oudehm/seniorDesignPCB/light_PCB/light_PCB.kicad_pcb

## KiCad design light_PCB/light_PCB.kicad_pcb (2026-09-28)

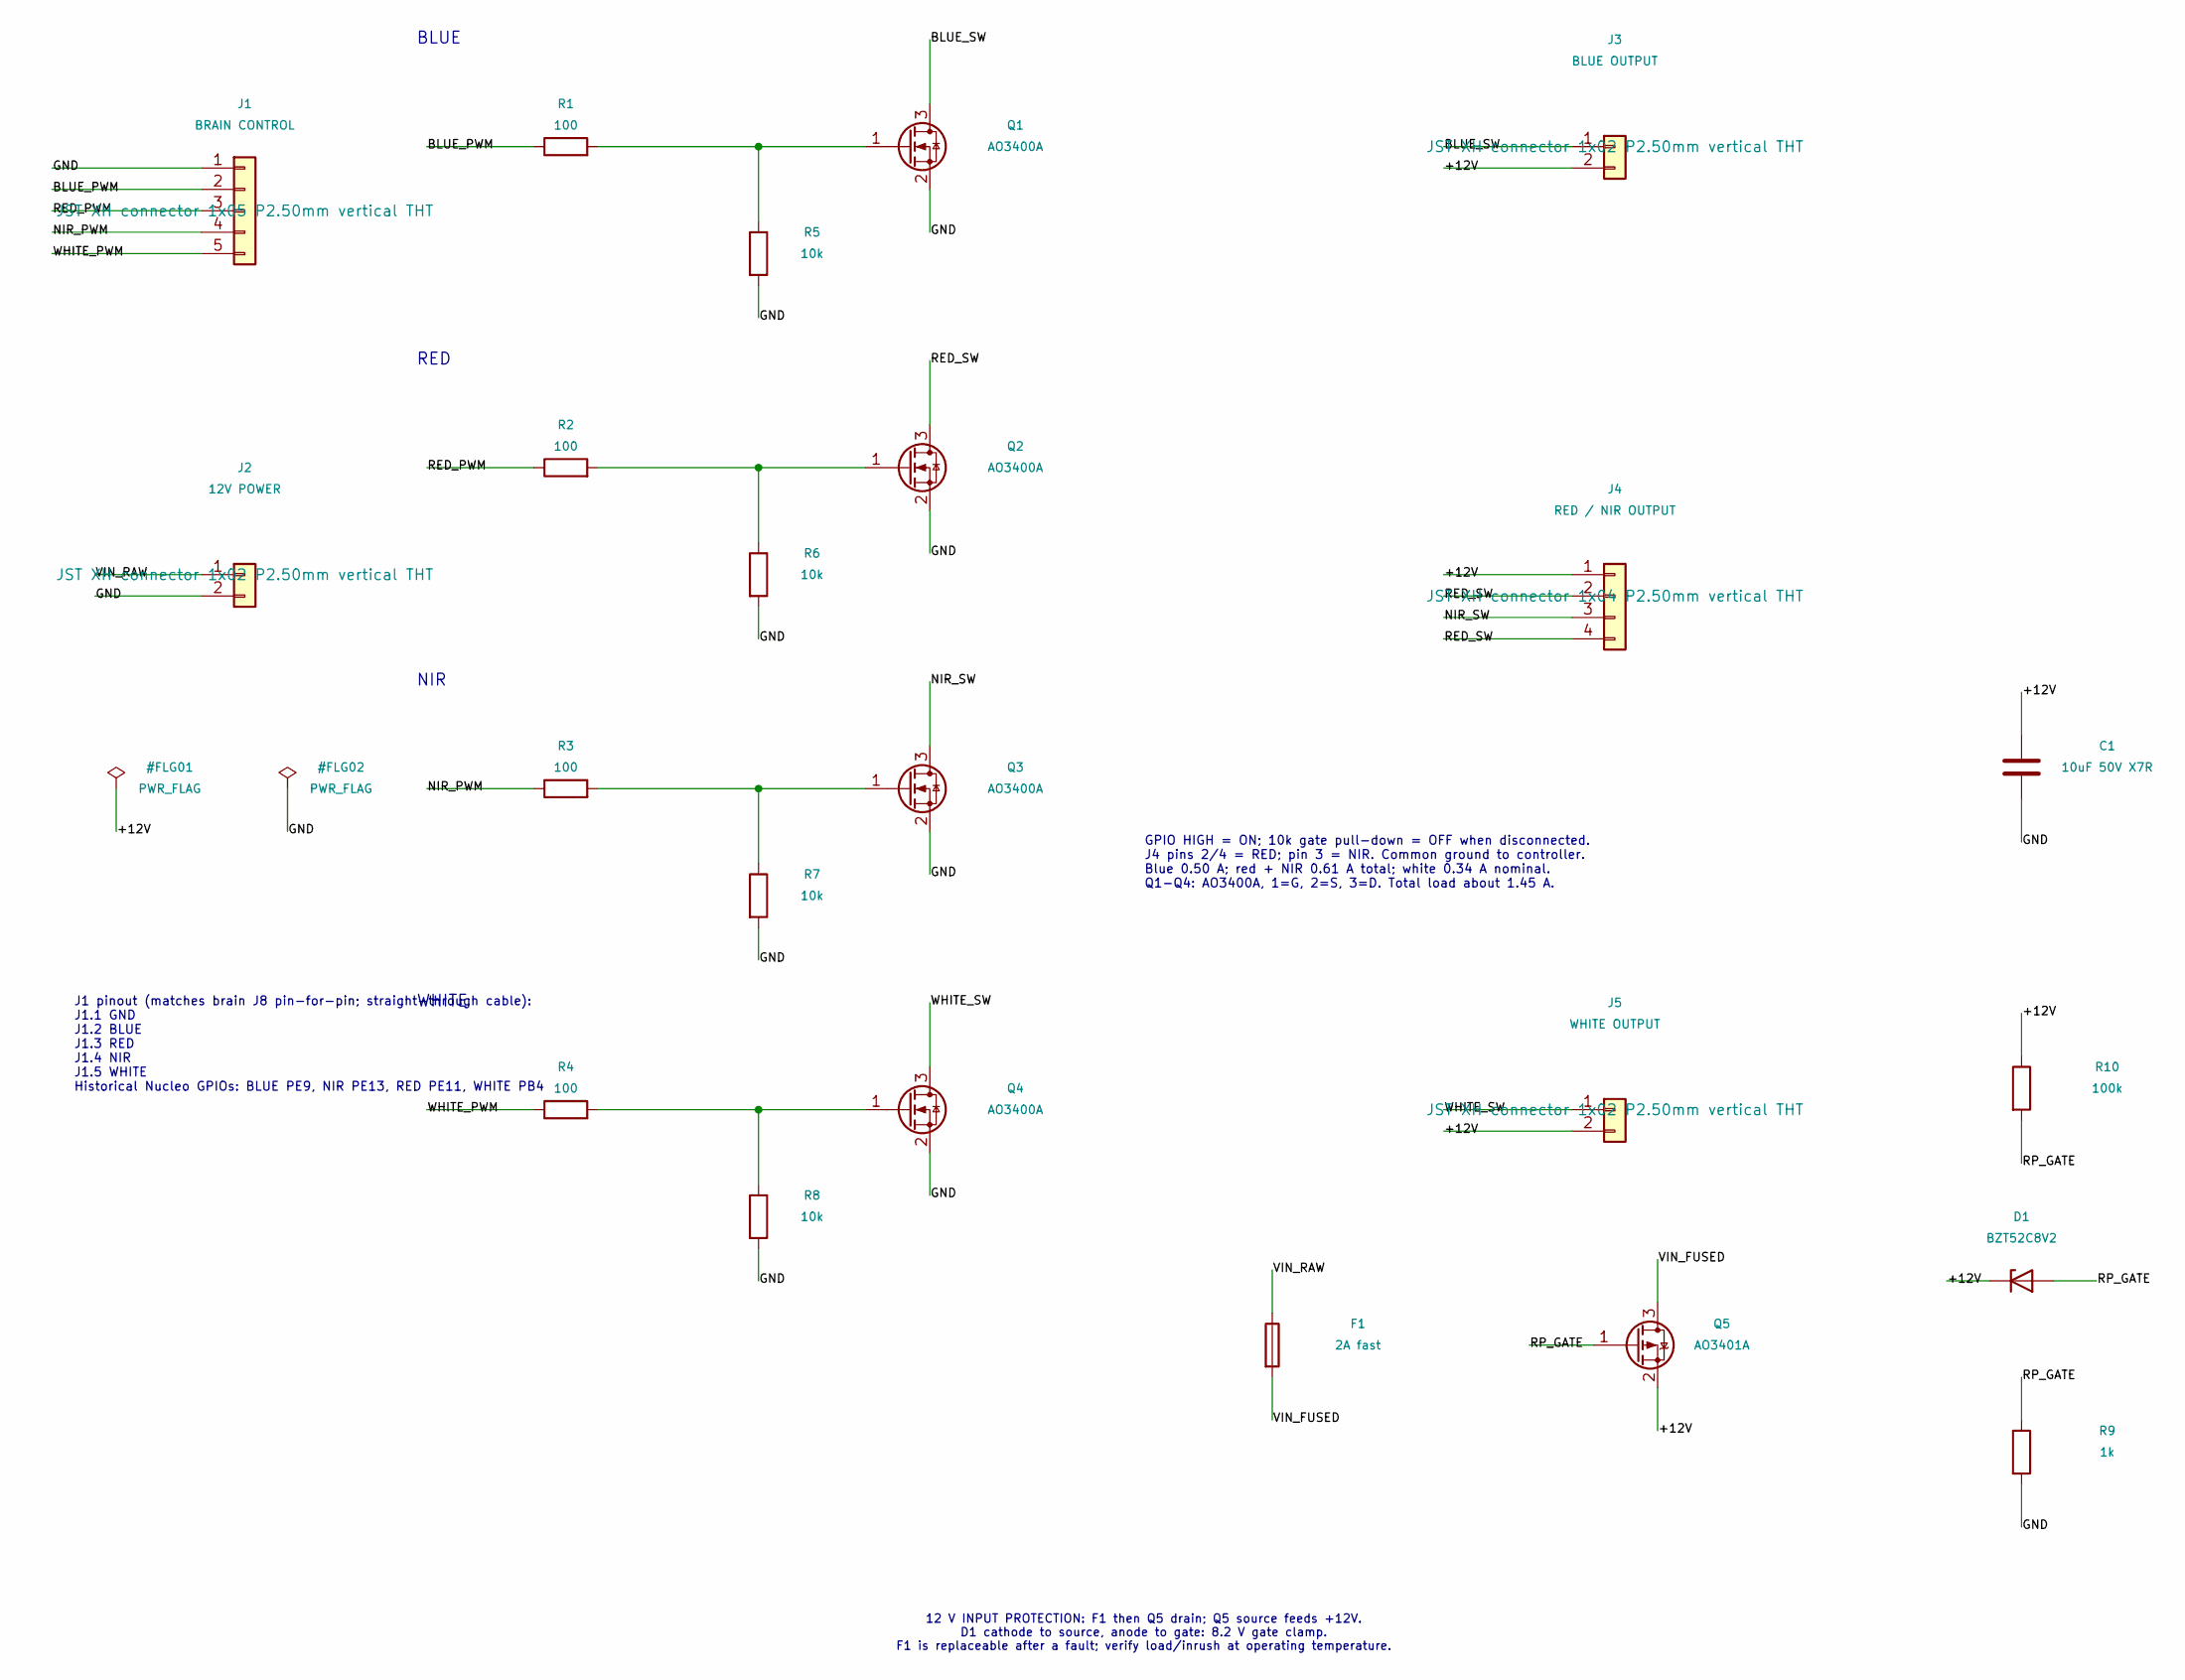
[picture p5: schematic light_PCB.kicad_sch, Hydroponic lights - protected 12 V / SMD]

Parts:
C1: 10uF 50V X7R; C_1210_3225Metric; MPN GRM32ER71H106KA12L; LCSC C77102
D1: BZT52C8V2; D_SOD-123; MPN BZT52C8V2-13-F; LCSC C3001623
F1: 2A fast; Fuse_1206_3216Metric; MPN 0466002.NRHF; LCSC C3105
J1: BRAIN CONTROL; JST_XH_B5B-XH-A_1x05_P2.50mm_Vertical; MPN B5B-XH-A(LF)(SN)
J2: 12V POWER; JST_XH_B2B-XH-A_1x02_P2.50mm_Vertical; MPN B2B-XH-A(LF)(SN)
J3: BLUE OUTPUT; JST_XH_B2B-XH-A_1x02_P2.50mm_Vertical; MPN B2B-XH-A(LF)(SN)
J4: RED / NIR OUTPUT; JST_XH_B4B-XH-A_1x04_P2.50mm_Vertical; MPN B4B-XH-A(LF)(SN)
J5: WHITE OUTPUT; JST_XH_B2B-XH-A_1x02_P2.50mm_Vertical; MPN B2B-XH-A(LF)(SN)
Q1, Q2, Q3, Q4: AO3400A; SOT-23; MPN AO3400A; LCSC C20917
Q5: AO3401A; SOT-23; MPN AO3401A; LCSC C15127
R1, R2, R3, R4: 100; R_0402_1005Metric_SilkClearance; MPN RC0402FR-07100RL; LCSC C106232
R5, R6, R7, R8: 10k; R_0402_1005Metric_SilkClearance; MPN RC0402FR-0710KL; LCSC C60490
R9: 1k; R_0603_1608Metric; MPN RC0603FR-071KL; LCSC C22548
R10: 100k; R_0603_1608Metric; MPN RC0603FR-07100KL; LCSC C14675

Connections:
/+12V: C1.1, D1.1 (K), J3.2, J4.1, J5.2, Q5.2 (S), R10.1
/BLUE_PWM: J1.2, R1.1
/BLUE_SW: J3.1, Q1.3 (D)
/GND: C1.2, J1.1, J2.2, Q1.2 (S), Q2.2 (S), Q3.2 (S), Q4.2 (S), R5.2, R6.2, R7.2, R8.2, R9.2
/NIR_PWM: J1.4, R3.1
/NIR_SW: J4.3, Q3.3 (D)
/RED_PWM: J1.3, R2.1
/RED_SW: J4.2, J4.4, Q2.3 (D)
/RP_GATE: D1.2 (A), Q5.1 (G), R9.1, R10.2
/VIN_FUSED: F1.2, Q5.3 (D)
/VIN_RAW: F1.1, J2.1
/WHITE_PWM: J1.5, R4.1
/WHITE_SW: J5.1, Q4.3 (D)
unnamed: Q1.1 (G), R1.2, R5.1
unnamed: Q2.1 (G), R2.2, R6.1
unnamed: Q3.1 (G), R3.2, R7.1
unnamed: Q4.1 (G), R4.2, R8.1

Notes on the sheet:
12 V INPUT PROTECTION: F1 then Q5 drain; Q5 source feeds +12V. D1 cathode to source, anode to gate: 8.2 V gate clamp. F1 is replaceable after a fault; verify load/inrush at operating temperature.
BLUE
WHITE
J1 pinout (matches brain J8 pin-for-pin; straight-through cable): J1.1 GND J1.2 BLUE J1.3 RED J1.4 NIR J1.5 WHITE Historical Nucleo GPIOs: BLUE PE9, NIR PE13, RED PE11, WHITE PB4
GPIO HIGH = ON; 10k gate pull-down = OFF when disconnected. J4 pins 2/4 = RED; pin 3 = NIR. Common ground to controller. Blue 0.50 A; red + NIR 0.61 A total; white 0.34 A nominal. Q1-Q4: AO3400A, 1=G, 2=S, 3=D. Total load about 1.45 A.
NIR
RED

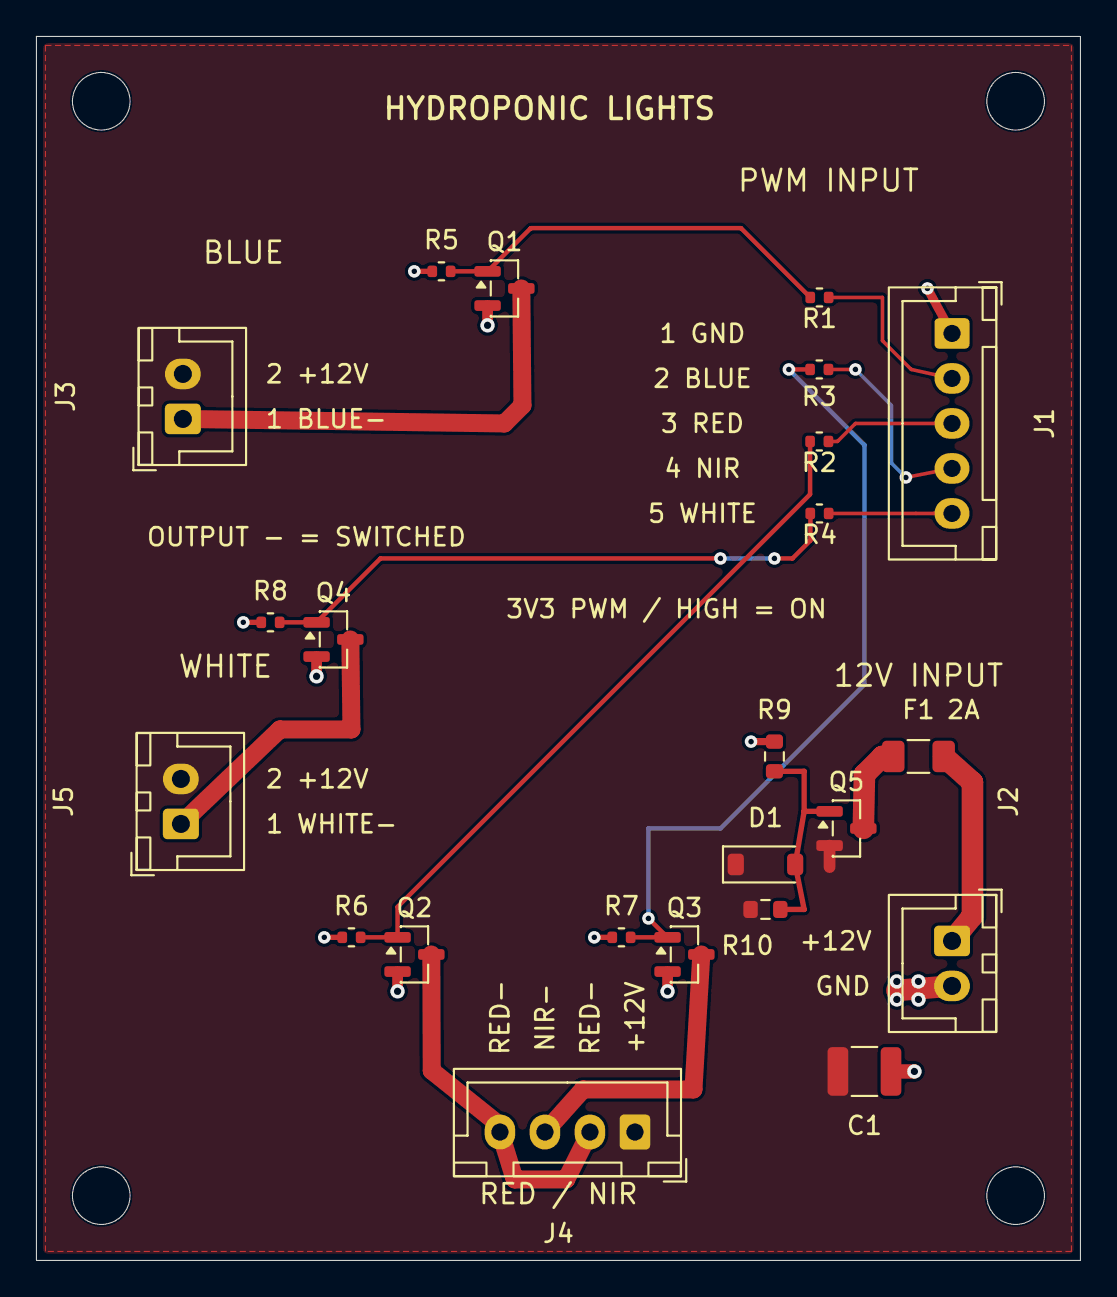
[picture p6: board light_PCB.kicad_pcb from above]

Board: 2 copper layers, 58.0 x 68.0 mm, 27 parts (0 on the bottom side), 17 nets.

Other parts of the board:
H1, H2, H3, H4: MountingHole_3.2mm_M3
