oudehm/seniorDesignPCB/brain_PCB/brain_PCB.kicad_pcb

## KiCad design brain_PCB/brain_PCB.kicad_pcb (2026-09-28)

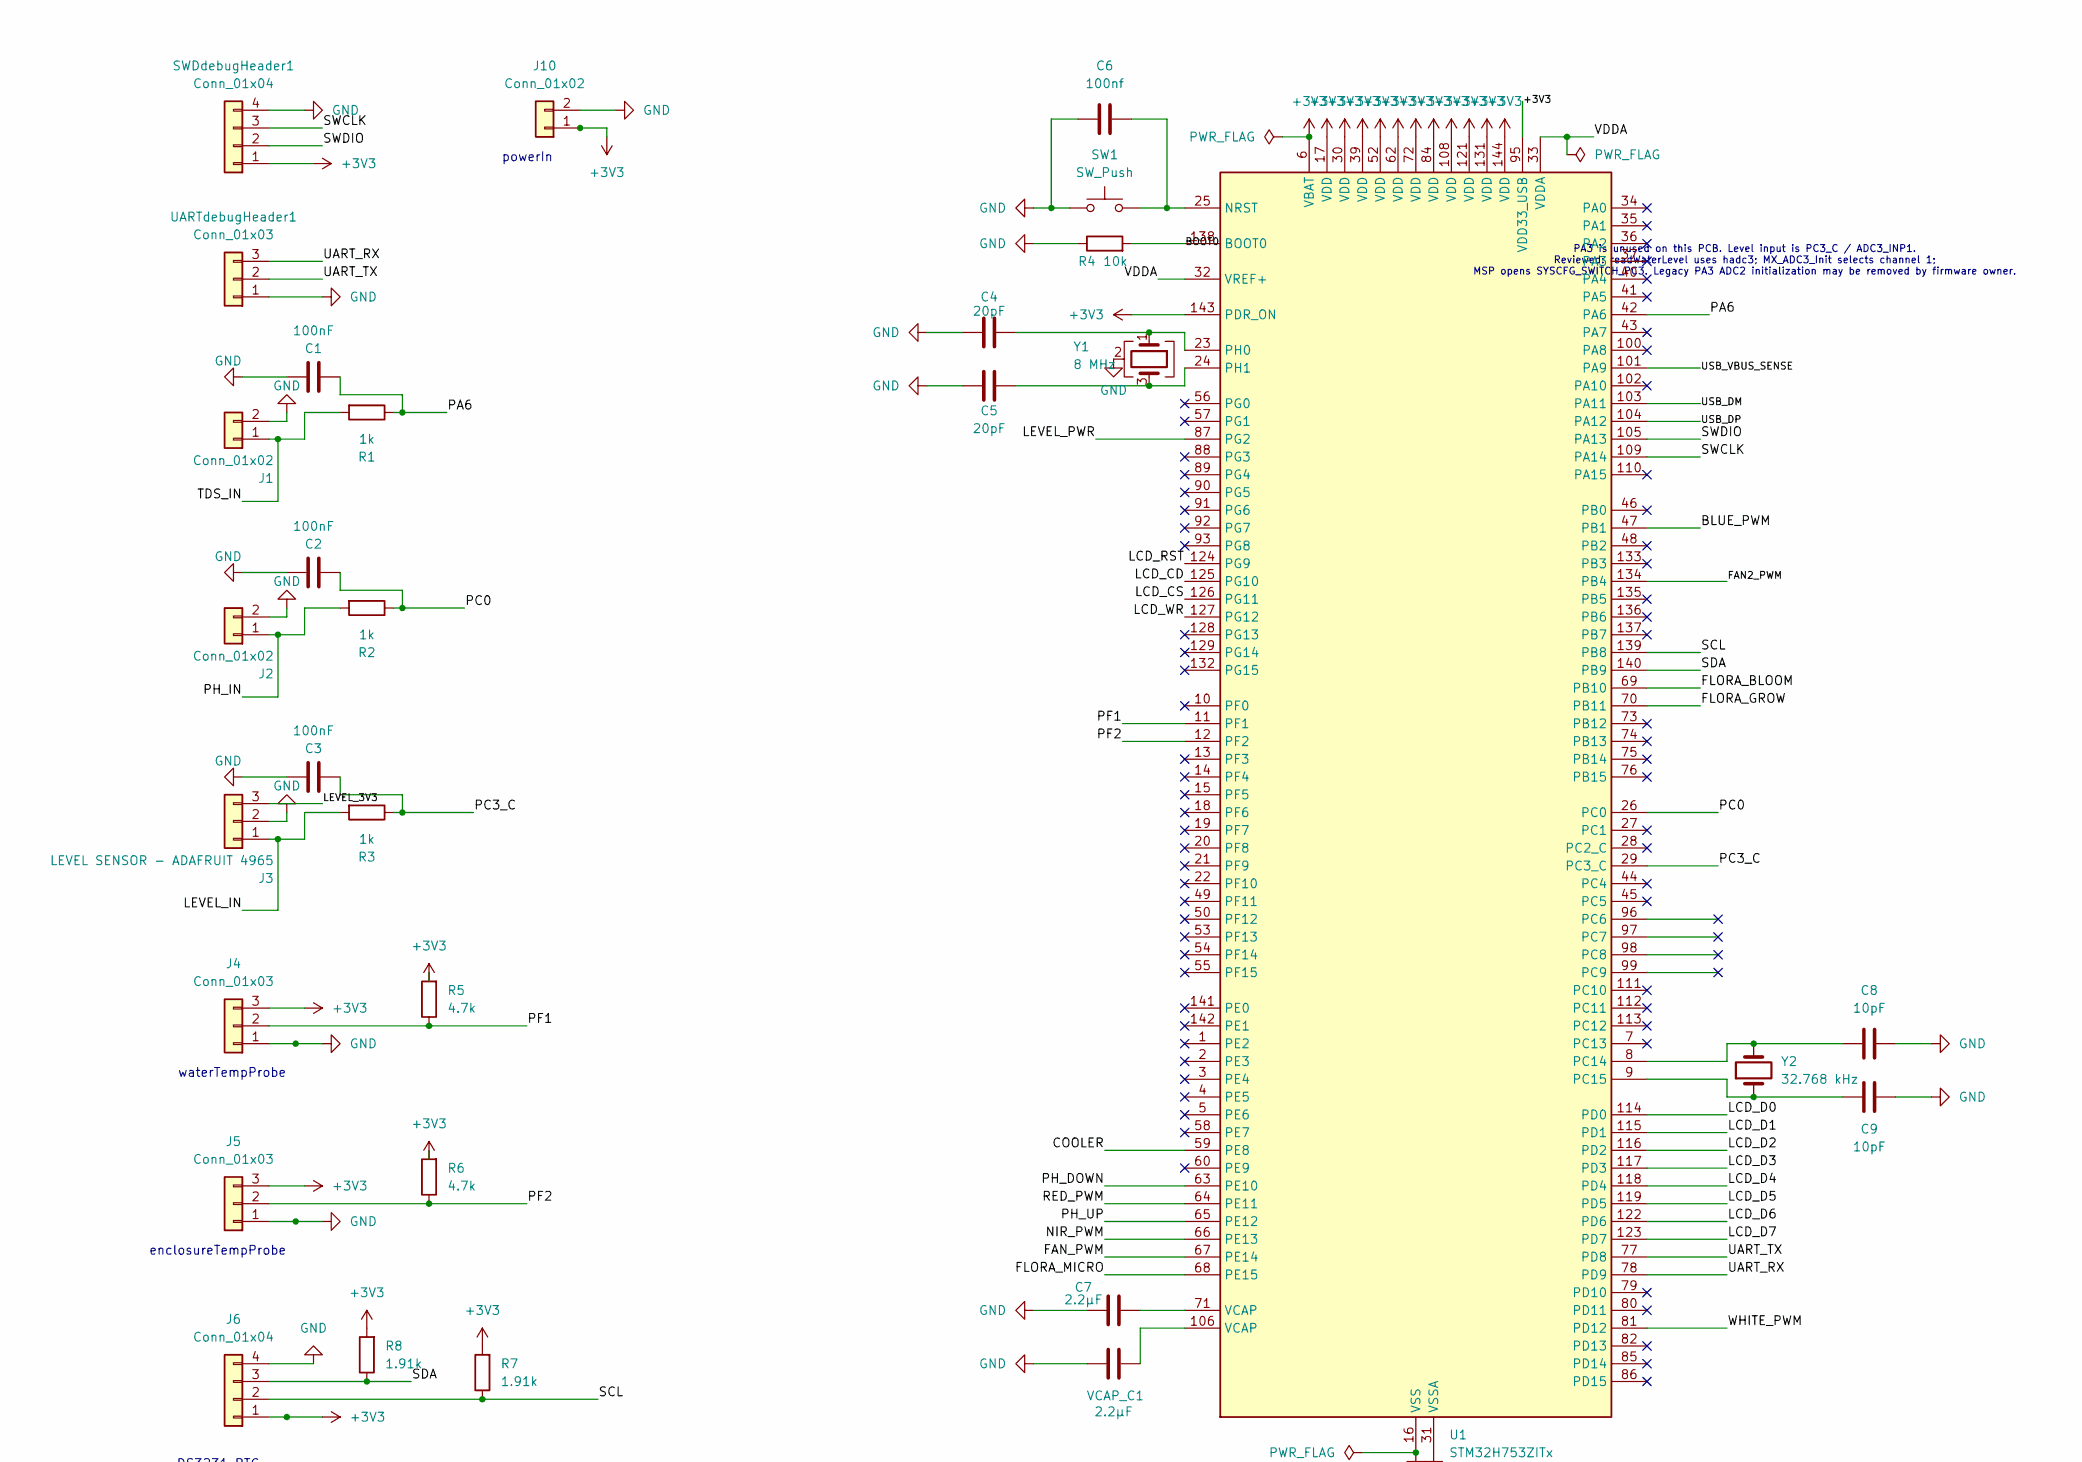
[picture p7: schematic brain_PCB.kicad_sch, part in row 1, column 1]

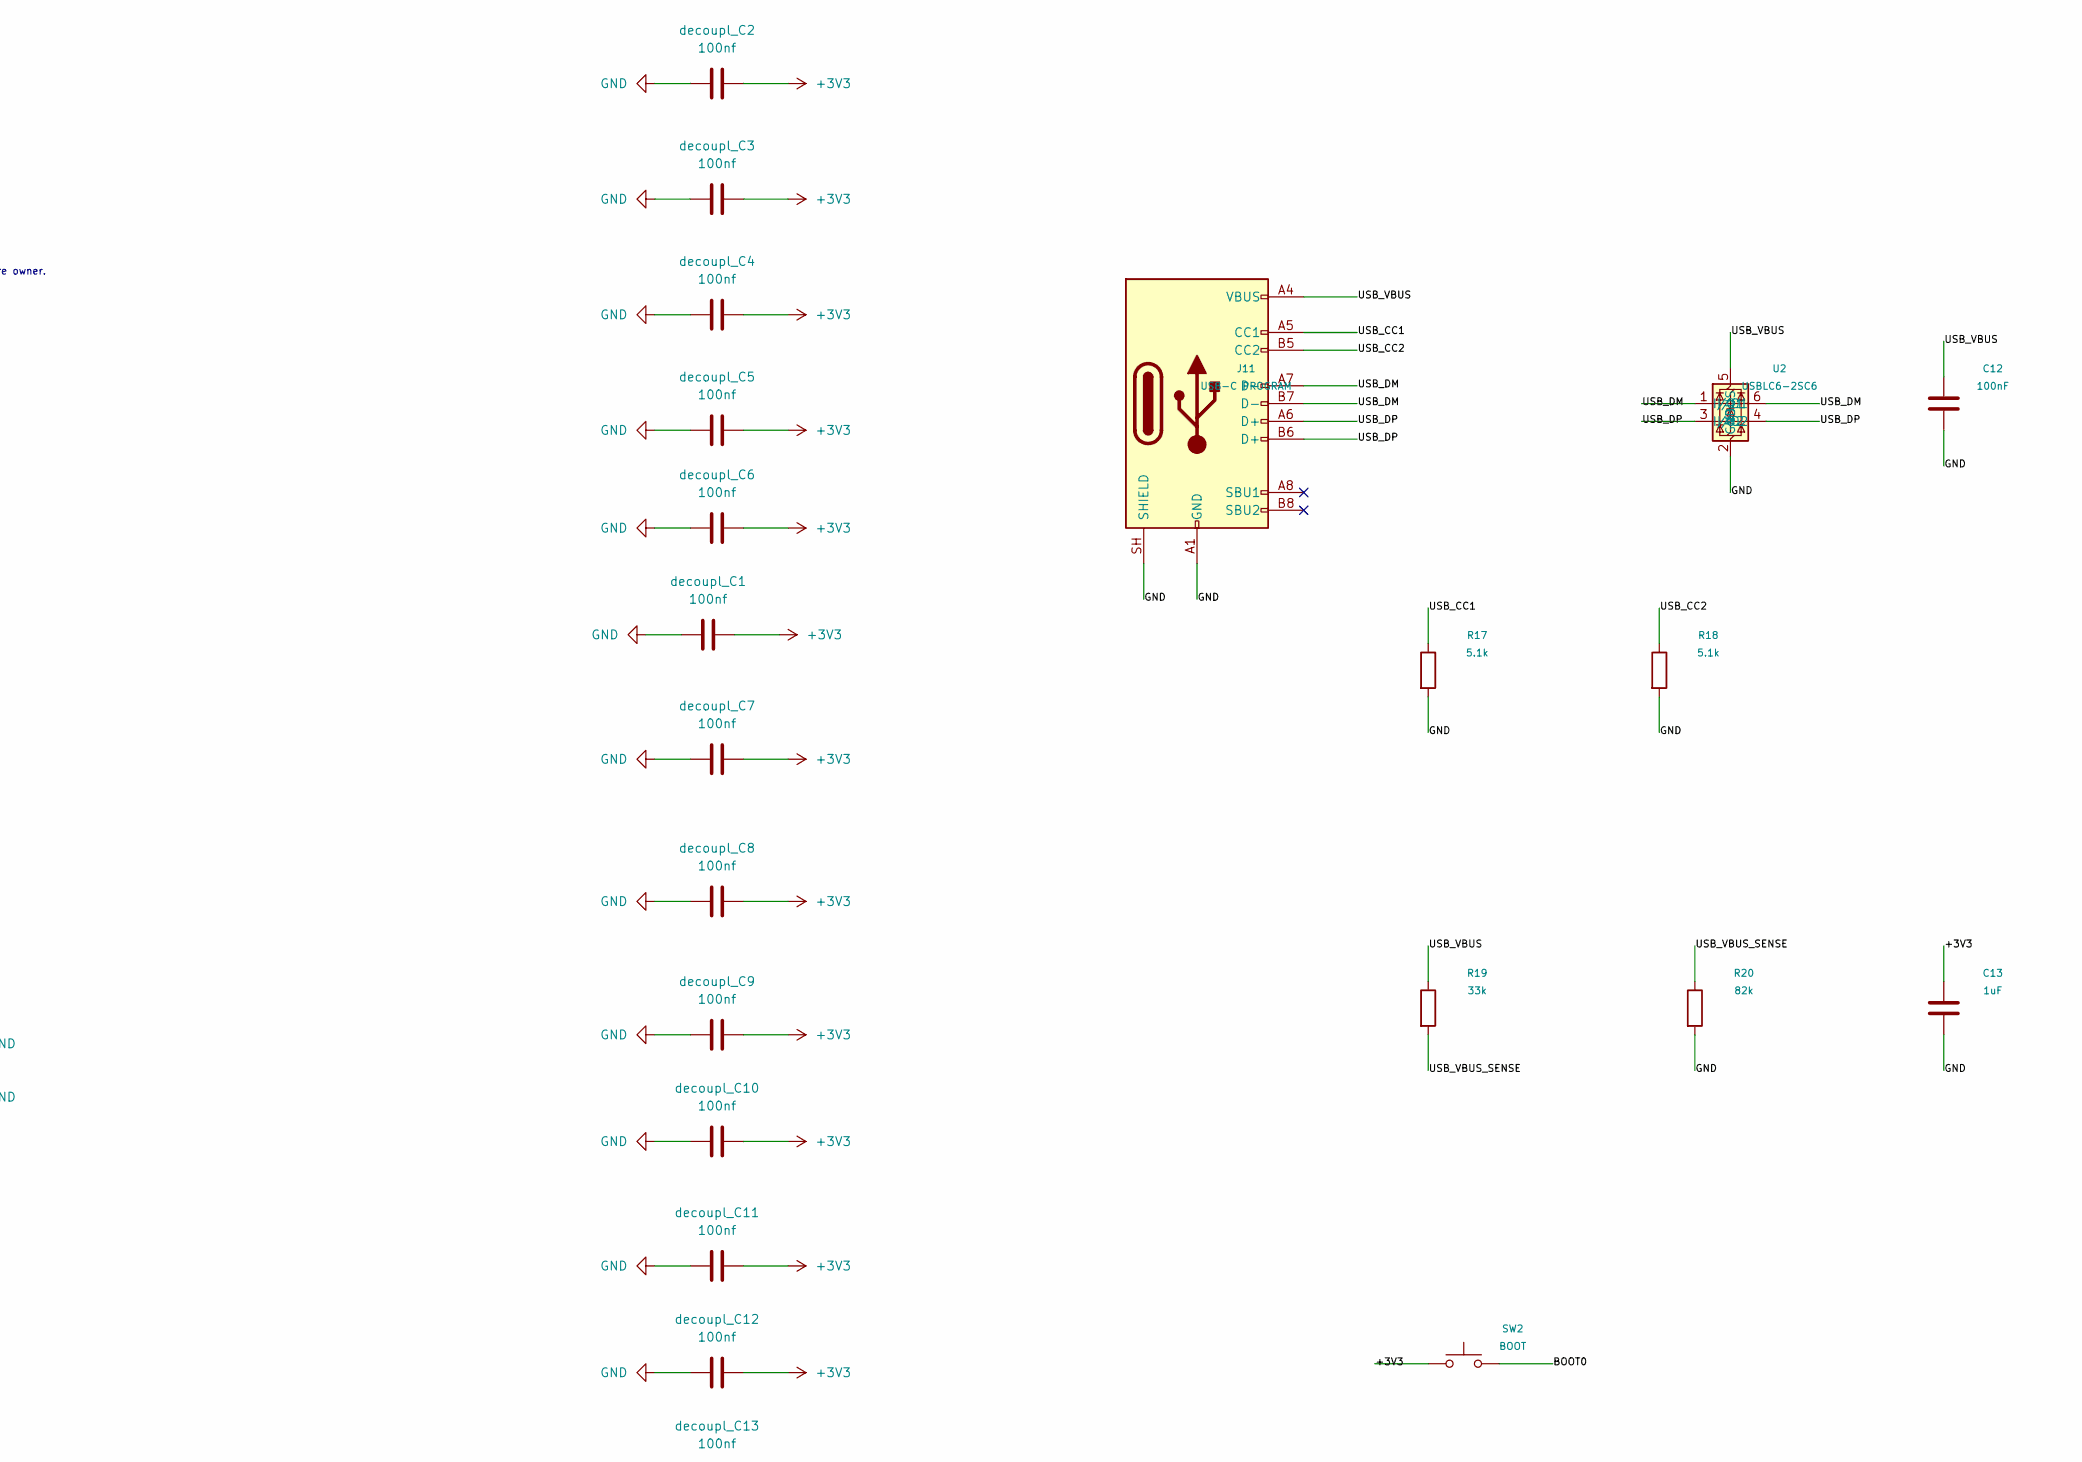
[picture p8: schematic brain_PCB.kicad_sch, part in row 1, column 2]

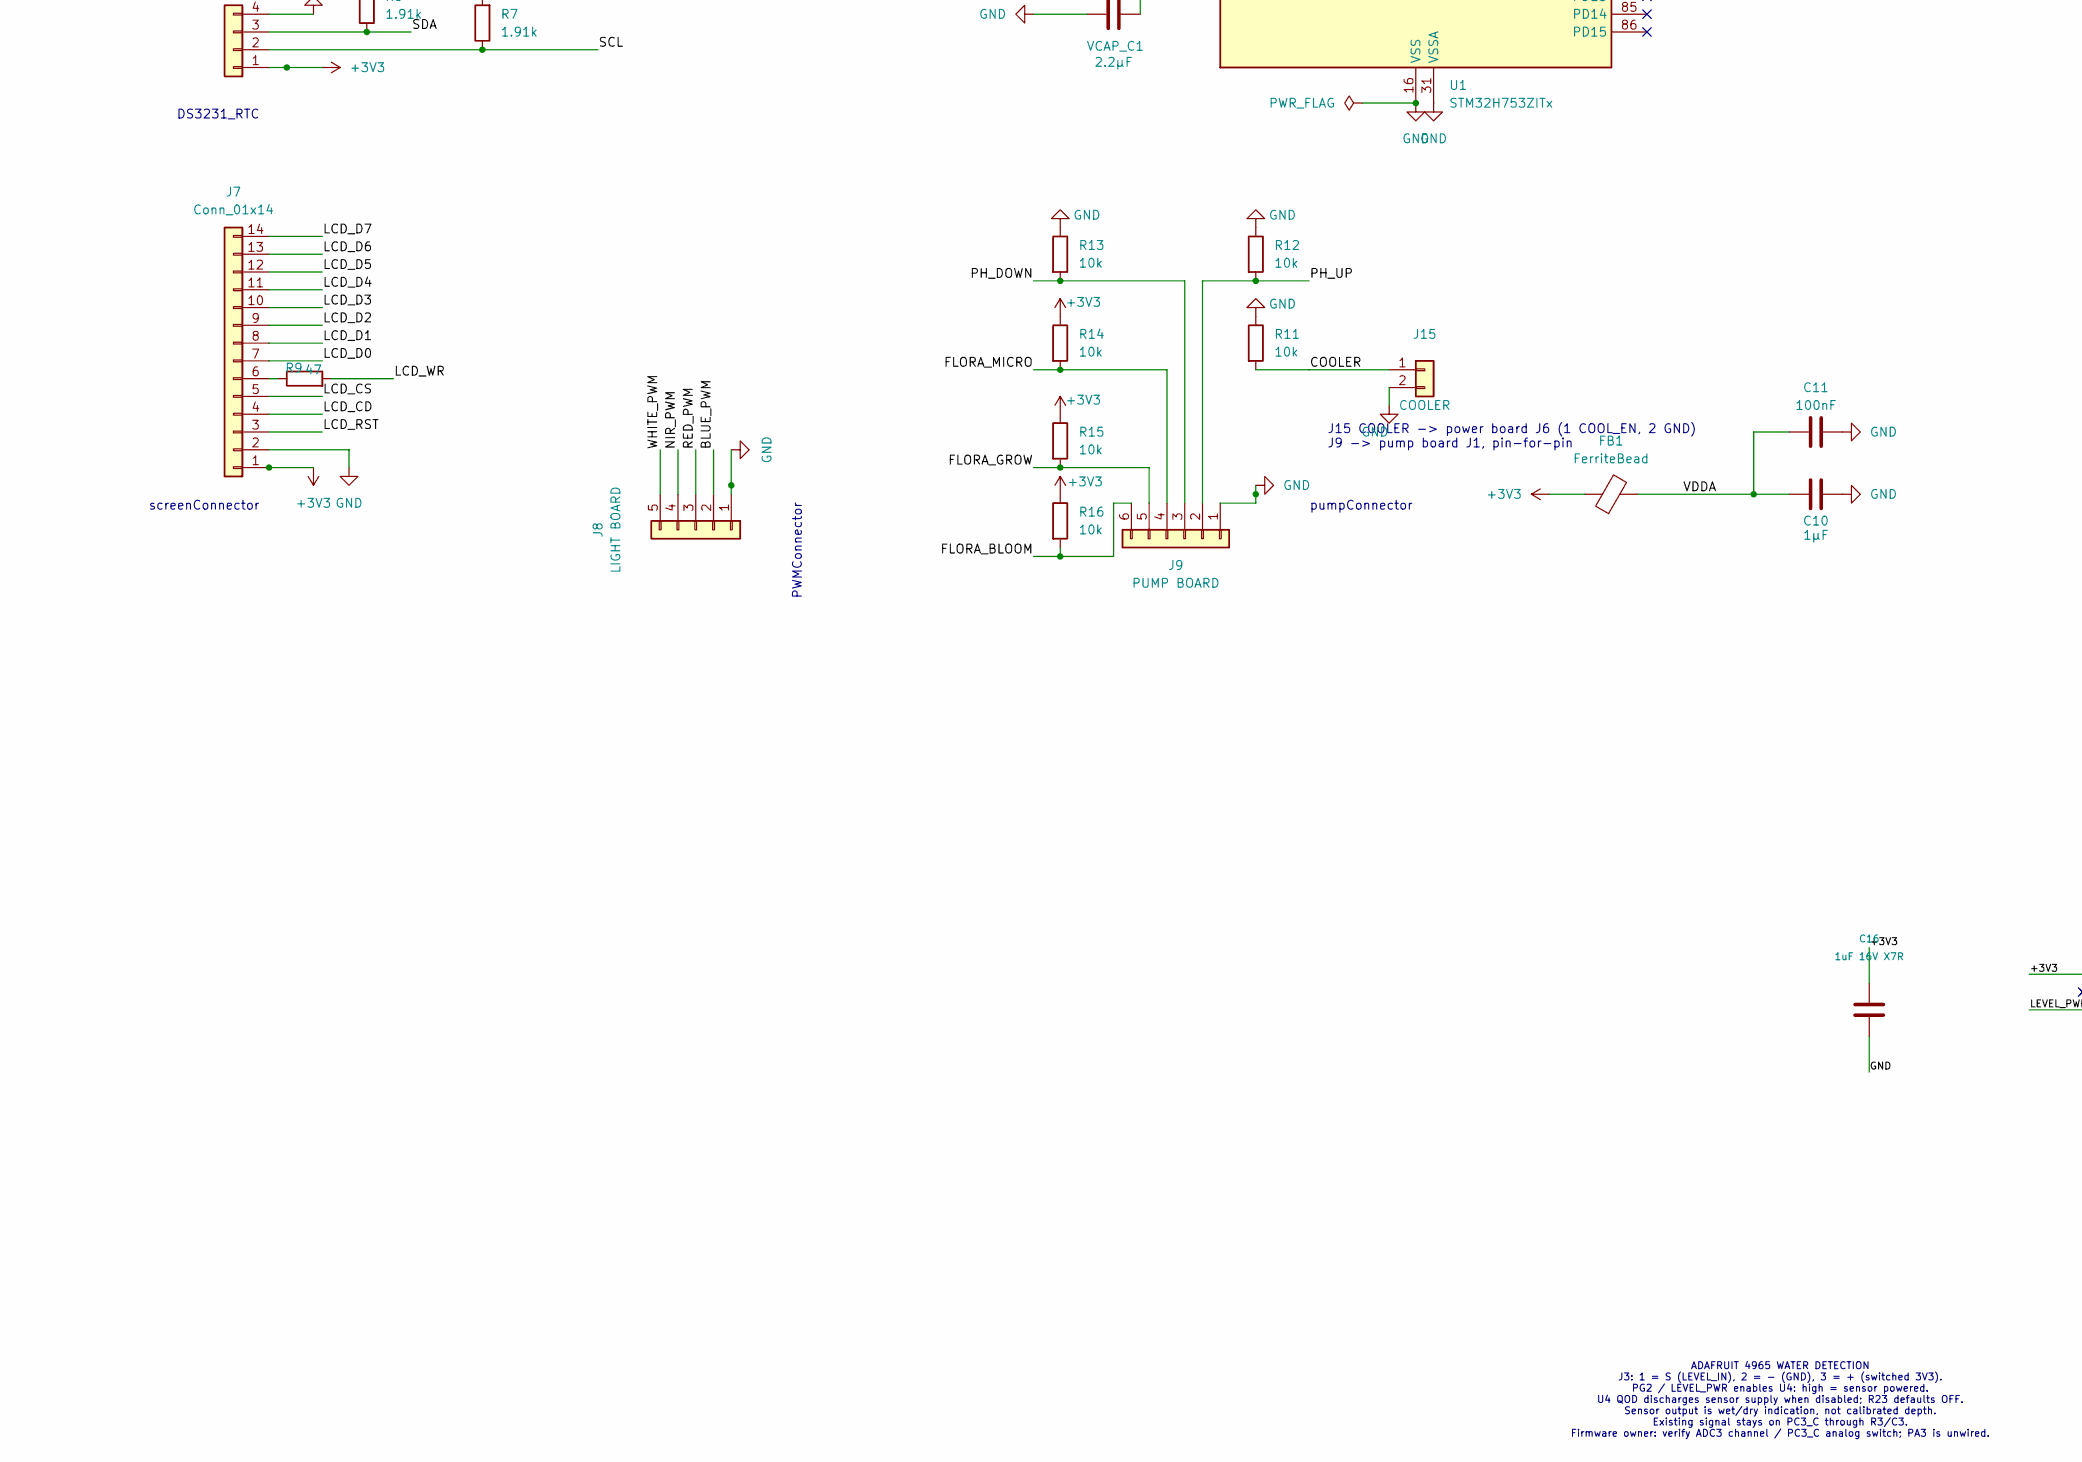
[picture p9: schematic brain_PCB.kicad_sch, part in row 2, column 1]

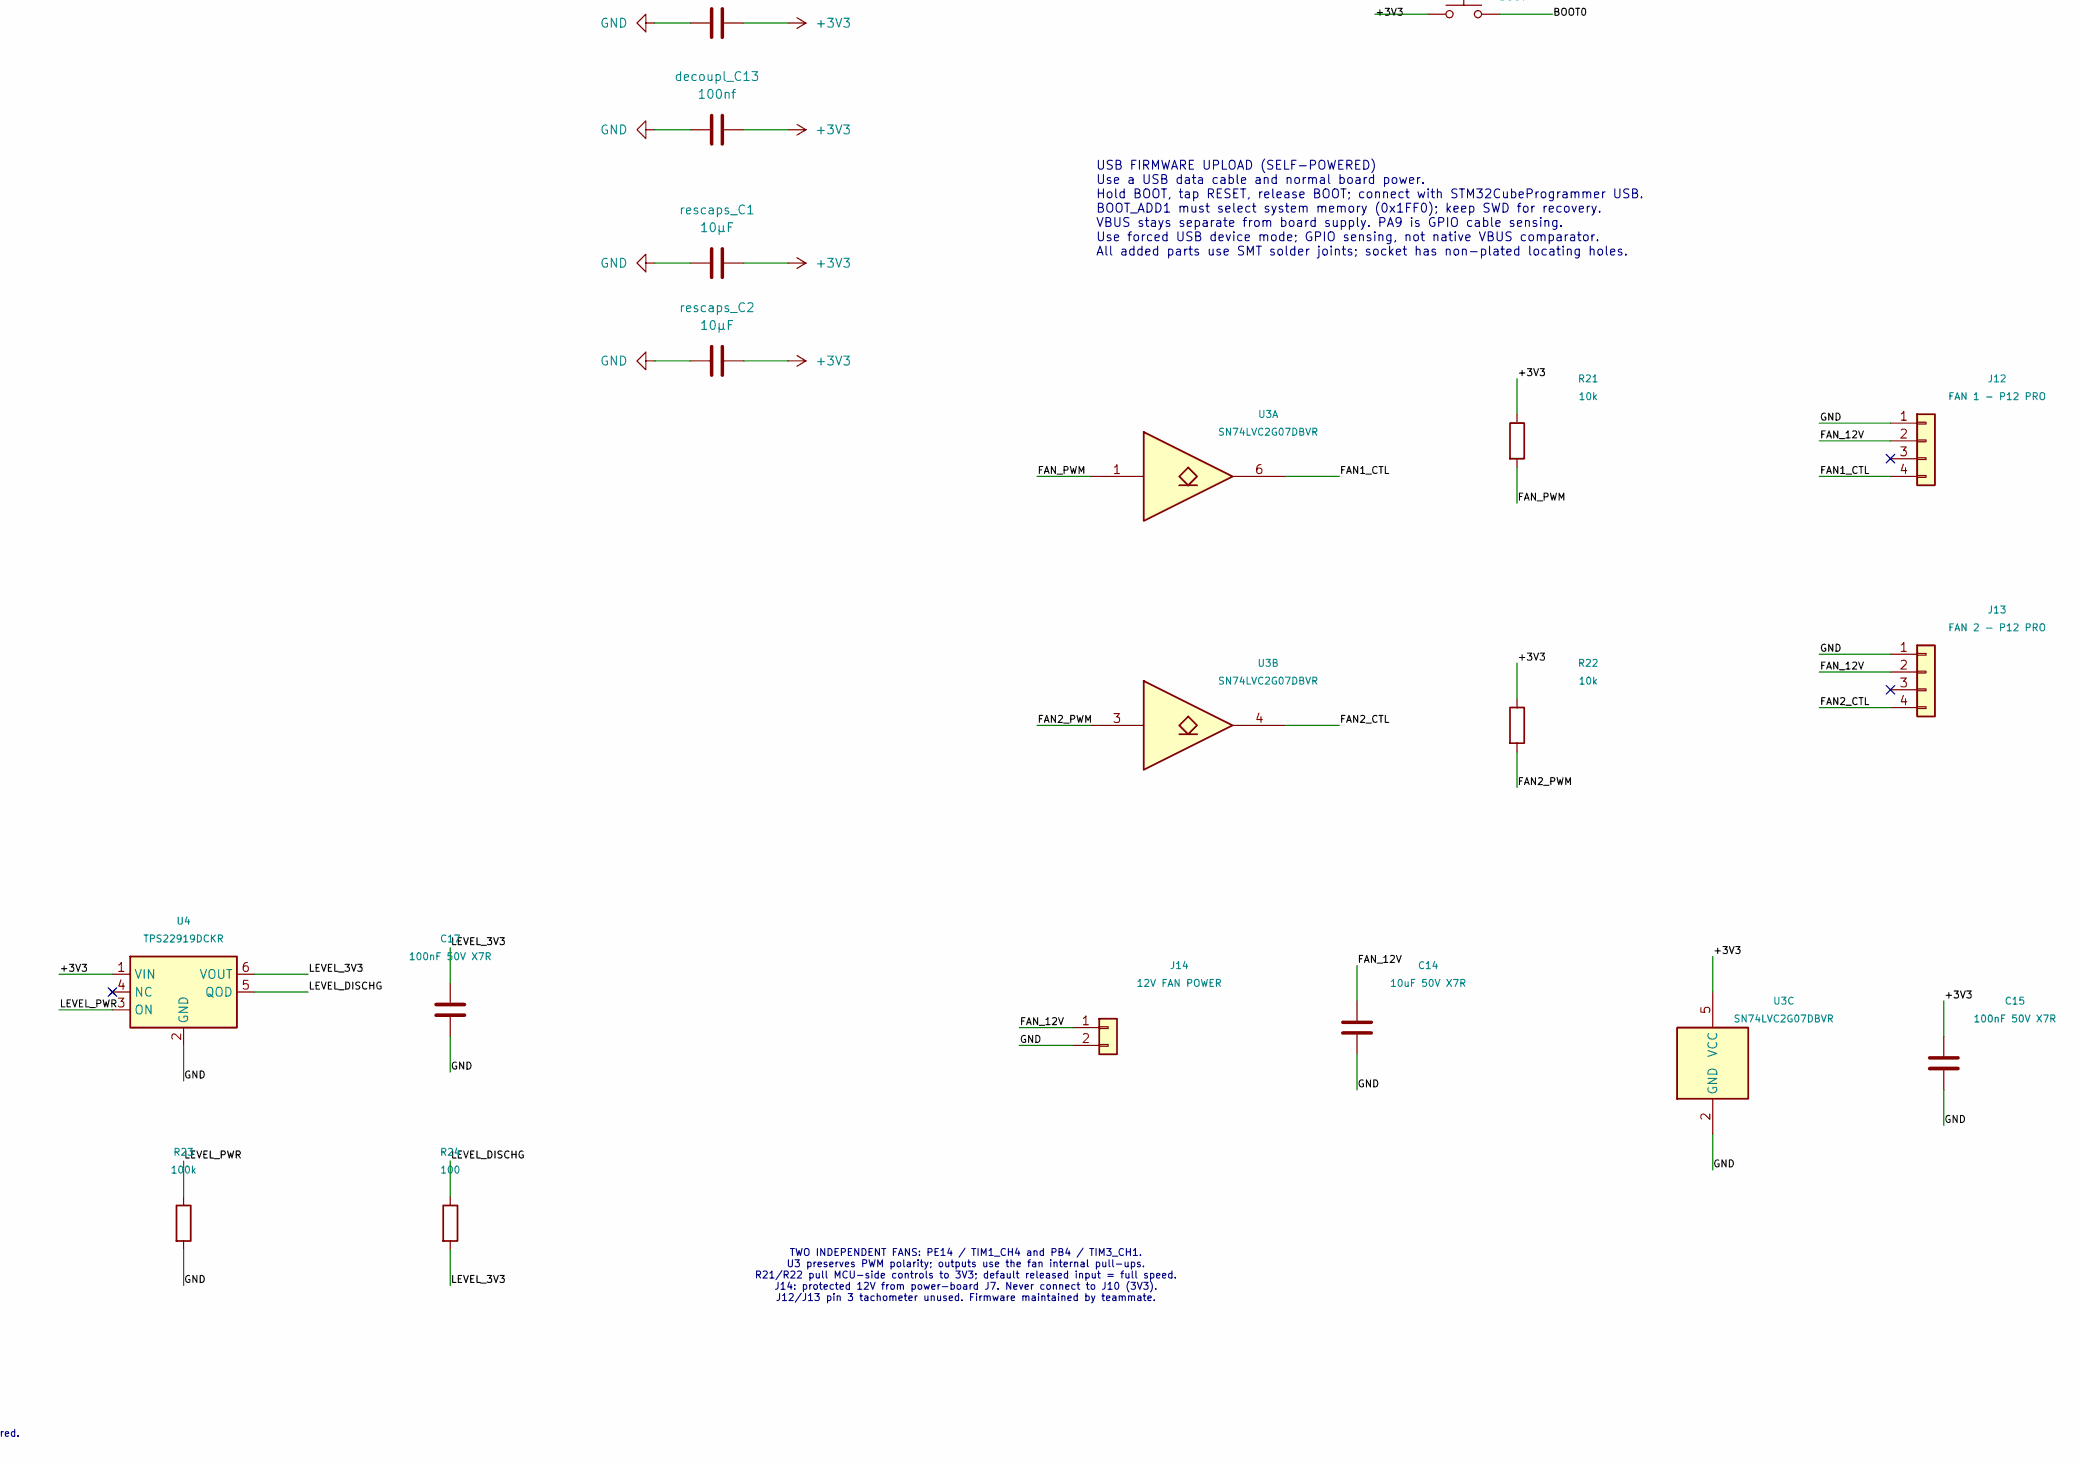
[picture p10: schematic brain_PCB.kicad_sch, part in row 2, column 2]

Parts:
C1: 100nF; C_0402_1005Metric_Reviewed_7; Rating 100nF 50V X7R; MPN GRM155R71H104KE14D; LCSC C77020
C2: 100nF; C_0402_1005Metric_Reviewed_2; Rating 100nF 50V X7R; MPN GRM155R71H104KE14D; LCSC C77020
C3: 100nF; C_0402_1005Metric_Reviewed_10; Rating 100nF 50V X7R; MPN GRM155R71H104KE14D; LCSC C77020
C4: 20pF; C_0402_1005Metric_Reviewed_8; Rating 20pF 50V C0G; MPN GRM1555C1H200JA01D; LCSC C76959
C5: 20pF; C_0402_1005Metric_Reviewed_4; Rating 20pF 50V C0G; MPN GRM1555C1H200JA01D; LCSC C76959
C6: 100nf; C_0402_1005Metric_Reviewed_9; Rating 100nF 50V X7R; MPN GRM155R71H104KE14D; LCSC C77020
C7: 2.2µF; C_0402_1005Metric_Reviewed_6; Rating 2.2uF 10V X5R; MPN GRM155R61A225KE95D; LCSC C77002
C8: 10pF; C_0402_1005Metric_Reviewed_12; Rating 10pF 50V C0G; MPN GRM1555C1H100JA01D; LCSC C76946
C9: 10pF; C_0402_1005Metric_Reviewed_4; Rating 10pF 50V C0G; MPN GRM1555C1H100JA01D; LCSC C76946
C10: 1µF; C_0402_1005Metric_Reviewed_4; Rating 1uF 10V X5R; MPN GRM155R61A105KE15D; LCSC C76999
C11: 100nF; C_0402_1005Metric_Reviewed_4; Rating 100nF 50V X7R; MPN GRM155R71H104KE14D; LCSC C77020
C12: 100nF; C_0402_1005Metric_Reviewed_3; MPN GRM155R71H104KE14D; LCSC C77020
C13: 1uF; C_0402_1005Metric_Reviewed_3; MPN GRM155R61A105KE15D; LCSC C76999
C14: 10uF 50V X7R; C_1210_3225Metric; MPN GRM32ER71H106KA12L; LCSC C77102
C15, C17: 100nF 50V X7R; C_0603_1608Metric; MPN GRM188R71H104KA93D; LCSC C77055
C16: 1uF 16V X7R; C_0603_1608Metric; Rating 1uF 25V X7R 10%, 0603; MPN GRM188R71E105KA12D; LCSC C86020
FB1: FerriteBead; L_0402_1005Metric; Rating 600 ohm at 100MHz; verify analog-rail D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; MPN BLM15AG601SN1D; LCSC C76884
J1, J2, J10: Conn_01x02; JST_XH_B2B-XH-A_1x02_P2.50mm_Vertical; MPN B2B-XH-A(LF)(SN)
J3: LEVEL SENSOR - ADAFRUIT 4965; JST_XH_B3B-XH-A_1x03_P2.50mm_Vertical; MPN B3B-XH-A(LF)(SN)
J4, J5: Conn_01x03; JST_XH_B3B-XH-A_1x03_P2.50mm_Vertical; MPN B3B-XH-A(LF)(SN)
J6: Conn_01x04; JST_XH_B4B-XH-A_1x04_P2.50mm_Vertical; MPN B4B-XH-A(LF)(SN)
J7: Conn_01x14; PinHeader_1x14_P2.54mm_Vertical; MPN 61301411121; LCSC C5907899
J8: LIGHT BOARD; JST_XH_B5B-XH-A_1x05_P2.50mm_Vertical; MPN B5B-XH-A(LF)(SN)
J9: PUMP BOARD; JST_XH_B6B-XH-A_1x06_P2.50mm_Vertical; MPN B6B-XH-A(LF)(SN)
J11: USB-C PROGRAM; USB_C_Receptacle_GCT_USB4110; MPN USB4110-GF-A; LCSC C5143397
J12: FAN 1 - P12 PRO; FanPinHeader_1x04_P2.54mm_Vertical; MPN 470531000; LCSC C240840
J13: FAN 2 - P12 PRO; FanPinHeader_1x04_P2.54mm_Vertical; MPN 470531000; LCSC C240840
J14: 12V FAN POWER; JST_XH_B2B-XH-A_1x02_P2.50mm_Vertical; MPN B2B-XH-A(LF)(SN)
J15: COOLER; JST_XH_B2B-XH-A_1x02_P2.50mm_Vertical; MPN B2B-XH-A(LF)(SN)
R1, R2, R3: 1k; R_0402_1005Metric_Reviewed_2; Rating 1%, 0402, 1/16W; MPN RC0402FR-071KL; LCSC C106235
R4, R11, R12, R13, R14, R15, R16: 10k; R_0402_1005Metric_Reviewed_1; Rating 1%, 0402, 1/16W; MPN RC0402FR-0710KL; LCSC C60490
R5: 4.7k; R_0402_1005Metric_Reviewed_1; Rating 1%, 0402, 1/16W; MPN RC0402FR-074K7L; LCSC C105871
R6: 4.7k; R_0402_1005Metric_Reviewed_6; Rating 1%, 0402, 1/16W; MPN RC0402FR-074K7L; LCSC C105871
R7, R8: 1.91k; R_0402_1005Metric_Reviewed_2; Rating 1.91kohm, 1%, 0402, 62.5mW; MPN RC0402FR-071K91L; LCSC C477598
R9: 47; R_0402_1005Metric_Reviewed_3; Rating 1%, 0402, 1/16W; MPN RC0402FR-0747RL; LCSC C137973
R17, R18: 5.1k; R_0402_1005Metric_Reviewed_5; MPN RC0402FR-075K1L; LCSC C105872
R19: 33k; R_0402_1005Metric_Reviewed_6; MPN RC0402FR-0733KL; LCSC C138003
R20: 82k; R_0402_1005Metric_Reviewed_4; MPN RC0402FR-0782KL; LCSC C137932
R21, R22: 10k; R_0603_1608Metric; MPN RC0603FR-0710KL; LCSC C98220
R23: 100k; R_0603_1608Metric; MPN RC0603FR-07100KL; LCSC C14675
R24: 100; R_0603_1608Metric; MPN RC0603FR-07100RL; LCSC C105588
SW1: SW_Push; SW_SPST_PTS645Sx43SMTR92; Rating SMT push switch; MPN PTS645SM43SMTR92 LFS; LCSC C221880
SW2: BOOT; SW_SPST_PTS645Sx43SMTR92; MPN PTS645SM43SMTR92 LFS; LCSC C221880
SWDdebugHeader1: Conn_01x04; PinHeader_1x04_P2.54mm_Vertical; MPN 61300411121; LCSC C5184785
U1: STM32H753ZITx; LQFP-144_20x20mm_P0.5mm; Rating LQFP144, -40 to 85C; MPN STM32H753ZIT6; LCSC C730207
U2: USBLC6-2SC6; SOT-23-6; MPN USBLC6-2SC6; LCSC C7519
U3: SN74LVC2G07DBVR; SOT-23-6; MPN SN74LVC2G07DBVR; LCSC C37708
U4: TPS22919DCKR; SOT-363_SC-70-6; MPN TPS22919DCKR; LCSC C2149796
UARTdebugHeader1: Conn_01x03; PinHeader_1x03_P2.54mm_Vertical; MPN 61300311121; LCSC C2915006
VCAP_C1: 2.2µF; C_0402_1005Metric_Reviewed_1; Rating 2.2uF 10V X5R; MPN GRM155R61A225KE95D; LCSC C77002
Y1: 8 MHz; Crystal_SMD_3225-4Pin_3.2x2.5mm_Reviewed_1; Rating 8MHz, CL=12pF, ESR max 400 ohm; MPN ECS-80-12-33-JGN-TR; LCSC C2442665
Y2: 32.768 kHz; Crystal_SMD_3215-2Pin_3.2x1.5mm_Reviewed_1; Rating 32.768kHz, CL=7pF; MPN ABS07-32.768KHZ-7-T; LCSC C276424
decoupl_C1, decoupl_C2, decoupl_C3: 100nf; C_0402_1005Metric_Reviewed_7; Rating 100nF 50V X7R; MPN GRM155R71H104KE14D; LCSC C77020
decoupl_C4, decoupl_C5, decoupl_C7: 100nf; C_0402_1005Metric_Reviewed_6; Rating 100nF 50V X7R; MPN GRM155R71H104KE14D; LCSC C77020
decoupl_C6: 100nf; C_0402_1005Metric_Reviewed_11; Rating 100nF 50V X7R; MPN GRM155R71H104KE14D; LCSC C77020
decoupl_C8, decoupl_C9, decoupl_C10: 100nf; C_0402_1005Metric_Reviewed_1; Rating 100nF 50V X7R; MPN GRM155R71H104KE14D; LCSC C77020
decoupl_C11, decoupl_C12: 100nf; C_0402_1005Metric_Reviewed_13; Rating 100nF 50V X7R; MPN GRM155R71H104KE14D; LCSC C77020
decoupl_C13: 100nf; C_0402_1005Metric_Reviewed_5; Rating 100nF 50V X7R; MPN GRM155R71H104KE14D; LCSC C77020
rescaps_C1, rescaps_C2: 10µF; C_0402_1005Metric_Reviewed_7; Rating 10uF 6.3V X5R; MPN GRM155R60J106ME15D; LCSC C412251

Connections:
+3V3: C13.1, C15.1, C16.1, FB1.1, J4.3, J5.3, J6.1, J7.1, J10.1, R5.2, R6.2, R7.2, R8.2, R14.1, R15.1, R16.1, R21.1, R22.1, SW2.1, SWDdebugHeader1.1, U1.6 (VBAT), U1.17 (VDD), U1.30 (VDD), U1.39 (VDD), U1.52 (VDD), U1.62 (VDD), U1.72 (VDD), U1.84 (VDD), U1.95 (VDD33_USB), U1.108 (VDD), U1.121 (VDD), U1.131 (VDD), U1.143 (PDR_ON), U1.144 (VDD), U3.5 (VCC), U4.1 (VIN), decoupl_C1.2, decoupl_C2.2, decoupl_C3.2, decoupl_C4.2, decoupl_C5.2, decoupl_C6.2, decoupl_C7.2, decoupl_C8.2, decoupl_C9.2, decoupl_C10.2, decoupl_C11.2, decoupl_C12.2, decoupl_C13.2, rescaps_C1.2, rescaps_C2.2
/BLUE_PWM: J8.2, U1.47 (PB1)
/BOOT0: R4.2, SW2.2, U1.138 (BOOT0)
/COOLER: J15.1, R11.2, U1.59 (PE8)
/FAN1_CTL: J12.4, U3.6
/FAN2_CTL: J13.4, U3.4
/FAN2_PWM: R22.2, U1.134 (PB4), U3.3
/FAN_12V: C14.1, J12.2, J13.2, J14.1
/FAN_PWM: R21.2, U1.67 (PE14), U3.1
/FLORA_BLOOM: J9.6, R16.2, U1.69 (PB10)
/FLORA_GROW: J9.5, R15.2, U1.70 (PB11)
/FLORA_MICRO: J9.4, R14.2, U1.68 (PE15)
/LCD_CD: J7.4, U1.125 (PG10)
/LCD_CS: J7.5, U1.126 (PG11)
/LCD_D0: J7.7, U1.114 (PD0)
/LCD_D1: J7.8, U1.115 (PD1)
/LCD_D2: J7.9, U1.116 (PD2)
/LCD_D3: J7.10, U1.117 (PD3)
/LCD_D4: J7.11, U1.118 (PD4)
/LCD_D5: J7.12, U1.119 (PD5)
/LCD_D6: J7.13, U1.122 (PD6)
/LCD_D7: J7.14, U1.123 (PD7)
/LCD_RST: J7.3, U1.124 (PG9)
/LCD_WR: R9.2, U1.127 (PG12)
/LEVEL_3V3: C17.1, J3.3, R24.2, U4.6 (VOUT)
/LEVEL_DISCHG: R24.1, U4.5 (QOD)
/LEVEL_IN: J3.1, R3.2
/LEVEL_PWR: R23.1, U1.87 (PG2), U4.3 (ON)
/NIR_PWM: J8.4, U1.66 (PE13)
/PA6: C1.1, R1.1, U1.42 (PA6)
/PC0: C2.1, R2.1, U1.26 (PC0)
/PC3_C: C3.1, R3.1, U1.29 (PC3_C)
/PF1: J4.2, R5.1, U1.11 (PF1)
/PF2: J5.2, R6.1, U1.12 (PF2)
/PH_DOWN: J9.3, R13.2, U1.63 (PE10)
/PH_IN: J2.1, R2.2
/PH_UP: J9.2, R12.2, U1.65 (PE12)
/RED_PWM: J8.3, U1.64 (PE11)
/SCL: J6.2, R7.1, U1.139 (PB8)
/SDA: J6.3, R8.1, U1.140 (PB9)
/SWCLK: SWDdebugHeader1.3, U1.109 (PA14)
/SWDIO: SWDdebugHeader1.2, U1.105 (PA13)
/TDS_IN: J1.1, R1.2
/UART_RX: U1.78 (PD9), UARTdebugHeader1.3
/UART_TX: U1.77 (PD8), UARTdebugHeader1.2
/USB_CC1: J11.A5 (CC1), R17.1
/USB_CC2: J11.B5 (CC2), R18.1
/USB_DM: J11.A7 (D-), J11.B7 (D-), U1.103 (PA11), U2.1 (I/O1), U2.6 (I/O1)
/USB_DP: J11.A6 (D+), J11.B6 (D+), U1.104 (PA12), U2.3 (I/O2), U2.4 (I/O2)
/USB_VBUS: C12.1, J11.A4 (VBUS), J11.A9 (VBUS), J11.B4 (VBUS), J11.B9 (VBUS), R19.1, U2.5 (VBUS)
/USB_VBUS_SENSE: R19.2, R20.1, U1.101 (PA9)
/VDDA: C10.1, C11.1, FB1.2, U1.32 (VREF+), U1.33 (VDDA)
/WHITE_PWM: J8.5, U1.81 (PD12)
GND: C1.2, C2.2, C3.2, C4.1, C5.2, C6.1, C7.1, C8.1, C9.2, C10.2, C11.2, C12.2, C13.2, C14.2, C15.2, C16.2, C17.2, J1.2, J2.2, J3.2, J4.1, J5.1, J6.4, J7.2, J8.1, J9.1, J10.2, J11.A1 (GND), J11.A12 (GND), J11.B1 (GND), J11.B12 (GND), J11.SH (SHIELD), J12.1, J13.1, J14.2, J15.2, R4.1, R11.1, R12.1, R13.1, R17.2, R18.2, R20.2, R23.2, SW1.1, SWDdebugHeader1.4, U1.16 (VSS), U1.31 (VSSA), U1.38 (VSS), U1.51 (VSS), U1.61 (VSS), U1.83 (VSS), U1.94 (VSS), U1.107 (VSS), U1.120 (VSS), U1.130 (VSS), U2.2 (GND), U3.2 (GND), U4.2 (GND), UARTdebugHeader1.1, VCAP_C1.1, Y1.2, Y1.4 (G), decoupl_C1.1, decoupl_C2.1, decoupl_C3.1, decoupl_C4.1, decoupl_C5.1, decoupl_C6.1, decoupl_C7.1, decoupl_C8.1, decoupl_C9.1, decoupl_C10.1, decoupl_C11.1, decoupl_C12.1, decoupl_C13.1, rescaps_C1.1, rescaps_C2.1
unnamed: C7.2, U1.71 (VCAP)
unnamed: J7.6, R9.1
unnamed: C6.2, SW1.2, U1.25 (NRST)
unnamed: C8.2, U1.8 (PC14), Y2.2
unnamed: C9.1, U1.9 (PC15), Y2.1
unnamed: C4.2, U1.23 (PH0), Y1.1
unnamed: C5.1, U1.24 (PH1), Y1.3
unnamed: U1.106 (VCAP), VCAP_C1.2

Notes on the sheet:
DS3231_RTC
PWMConnector
powerIn
enclosureTempProbe
waterTempProbe
screenConnector
pumpConnector
J15 COOLER -> power board J6 (1 COOL_EN, 2 GND) J9 -> pump board J1, pin-for-pin
USB FIRMWARE UPLOAD (SELF-POWERED) Use a USB data cable and normal board power. Hold BOOT, tap RESET, release BOOT; connect with STM32CubeProgrammer USB. BOOT_ADD1 must select system memory (0x1FF0); keep SWD for recovery. VBUS stays separate from board supply. PA9 is GPIO cable sensing. Use forced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
TWO INDEPENDENT FANS: PE14 / TIM1_CH4 and PB4 / TIM3_CH1. U3 preserves PWM polarity; outputs use the fan internal pull-ups. R21/R22 pull MCU-side controls to 3V3; default released input = full speed. J14: protected 12V from power-board J7. Never connect to J10 (3V3). J12/J13 pin 3 tachometer unused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
ADAFRUIT 4965 WATER DETECTION J3: 1 = S (LEVEL_IN), 2 = - (GND), 3 = + (switched 3V3). PG2 / LEVEL_PWR enables U4: high = sensor powered. U4 QOD discharges sensor supply when disabled; R23 defaults OFF. Sensor output is wet/dry indication, not calibrated depth. Existing signal stays on PC3_C throug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
PA3 is unused on this PCB. Level input is PC3_C / ADC3_INP1. Reviewed: readWaterLevel uses hadc3; MX_ADC3_Init selects channel 1; MSP opens SYSCFG_SWITCH_PC3. Legacy PA3 ADC2 initialization may be removed by firmware owner.

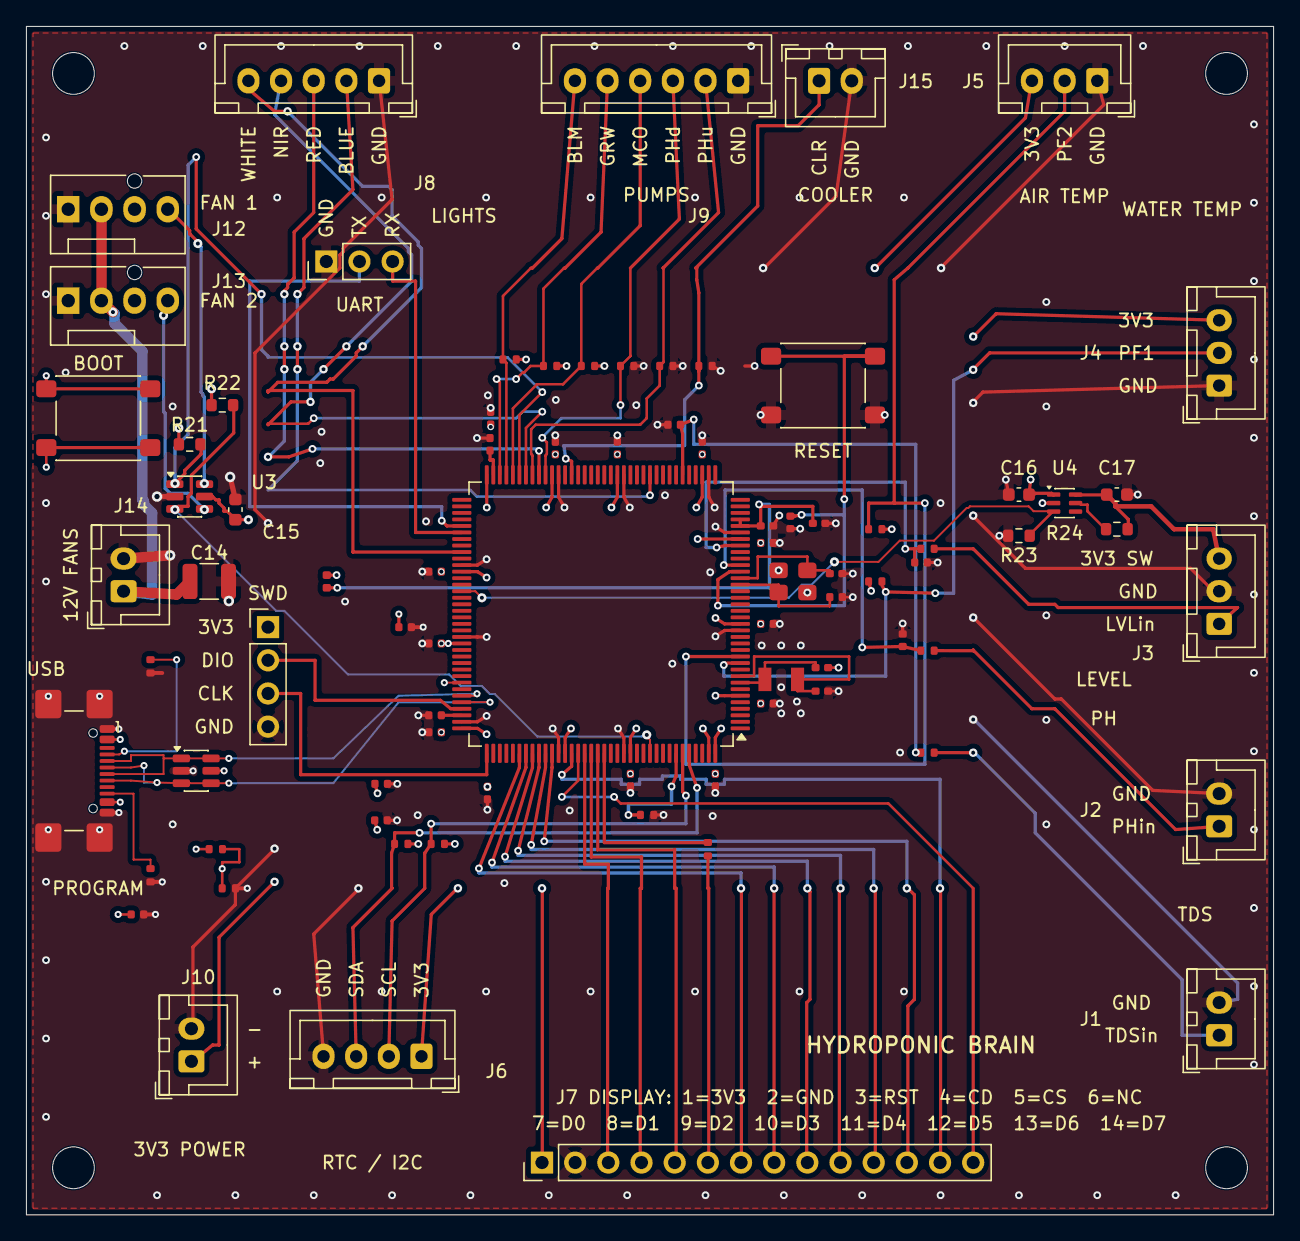
[picture p11: board brain_PCB.kicad_pcb from above]

Board: 4 copper layers, 95.5 x 91.0 mm, 86 parts (0 on the bottom side), 62 nets.

Other parts of the board:
H1, H2, H3, H4: MountingHole_3.2mm_M3
