oudehm/seniorDesignPCB/power_PCB/power_PCB.kicad_pcb

## KiCad design power_PCB/power_PCB.kicad_pcb (2026-09-28)

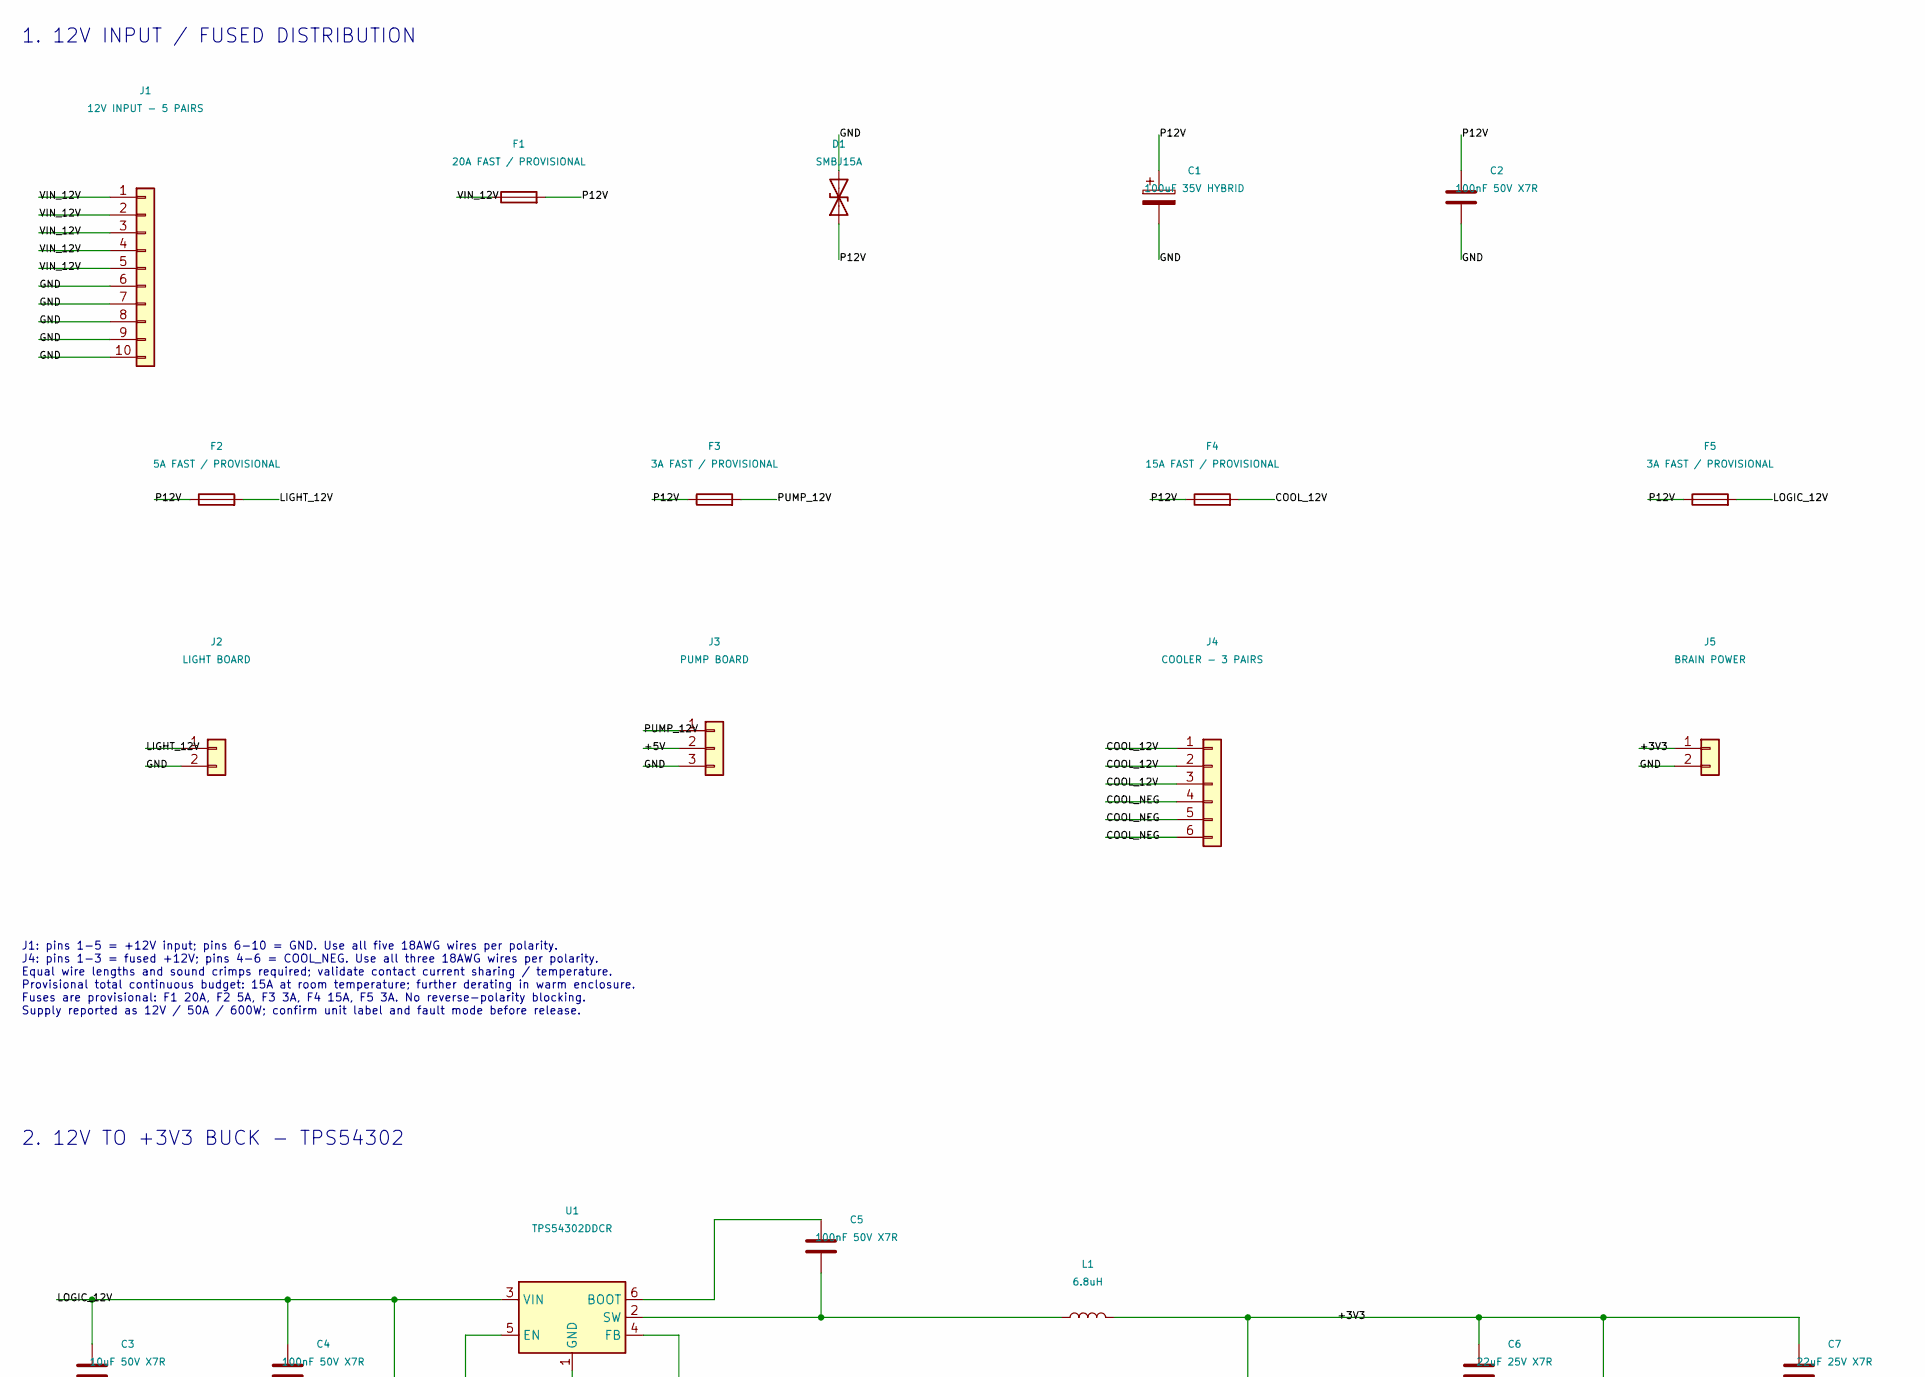
[picture p12: schematic power_PCB.kicad_sch, HYDROPONICS - POWER DISTRIBUTION AND COOLER CONTROL, part in row 1, column 1]

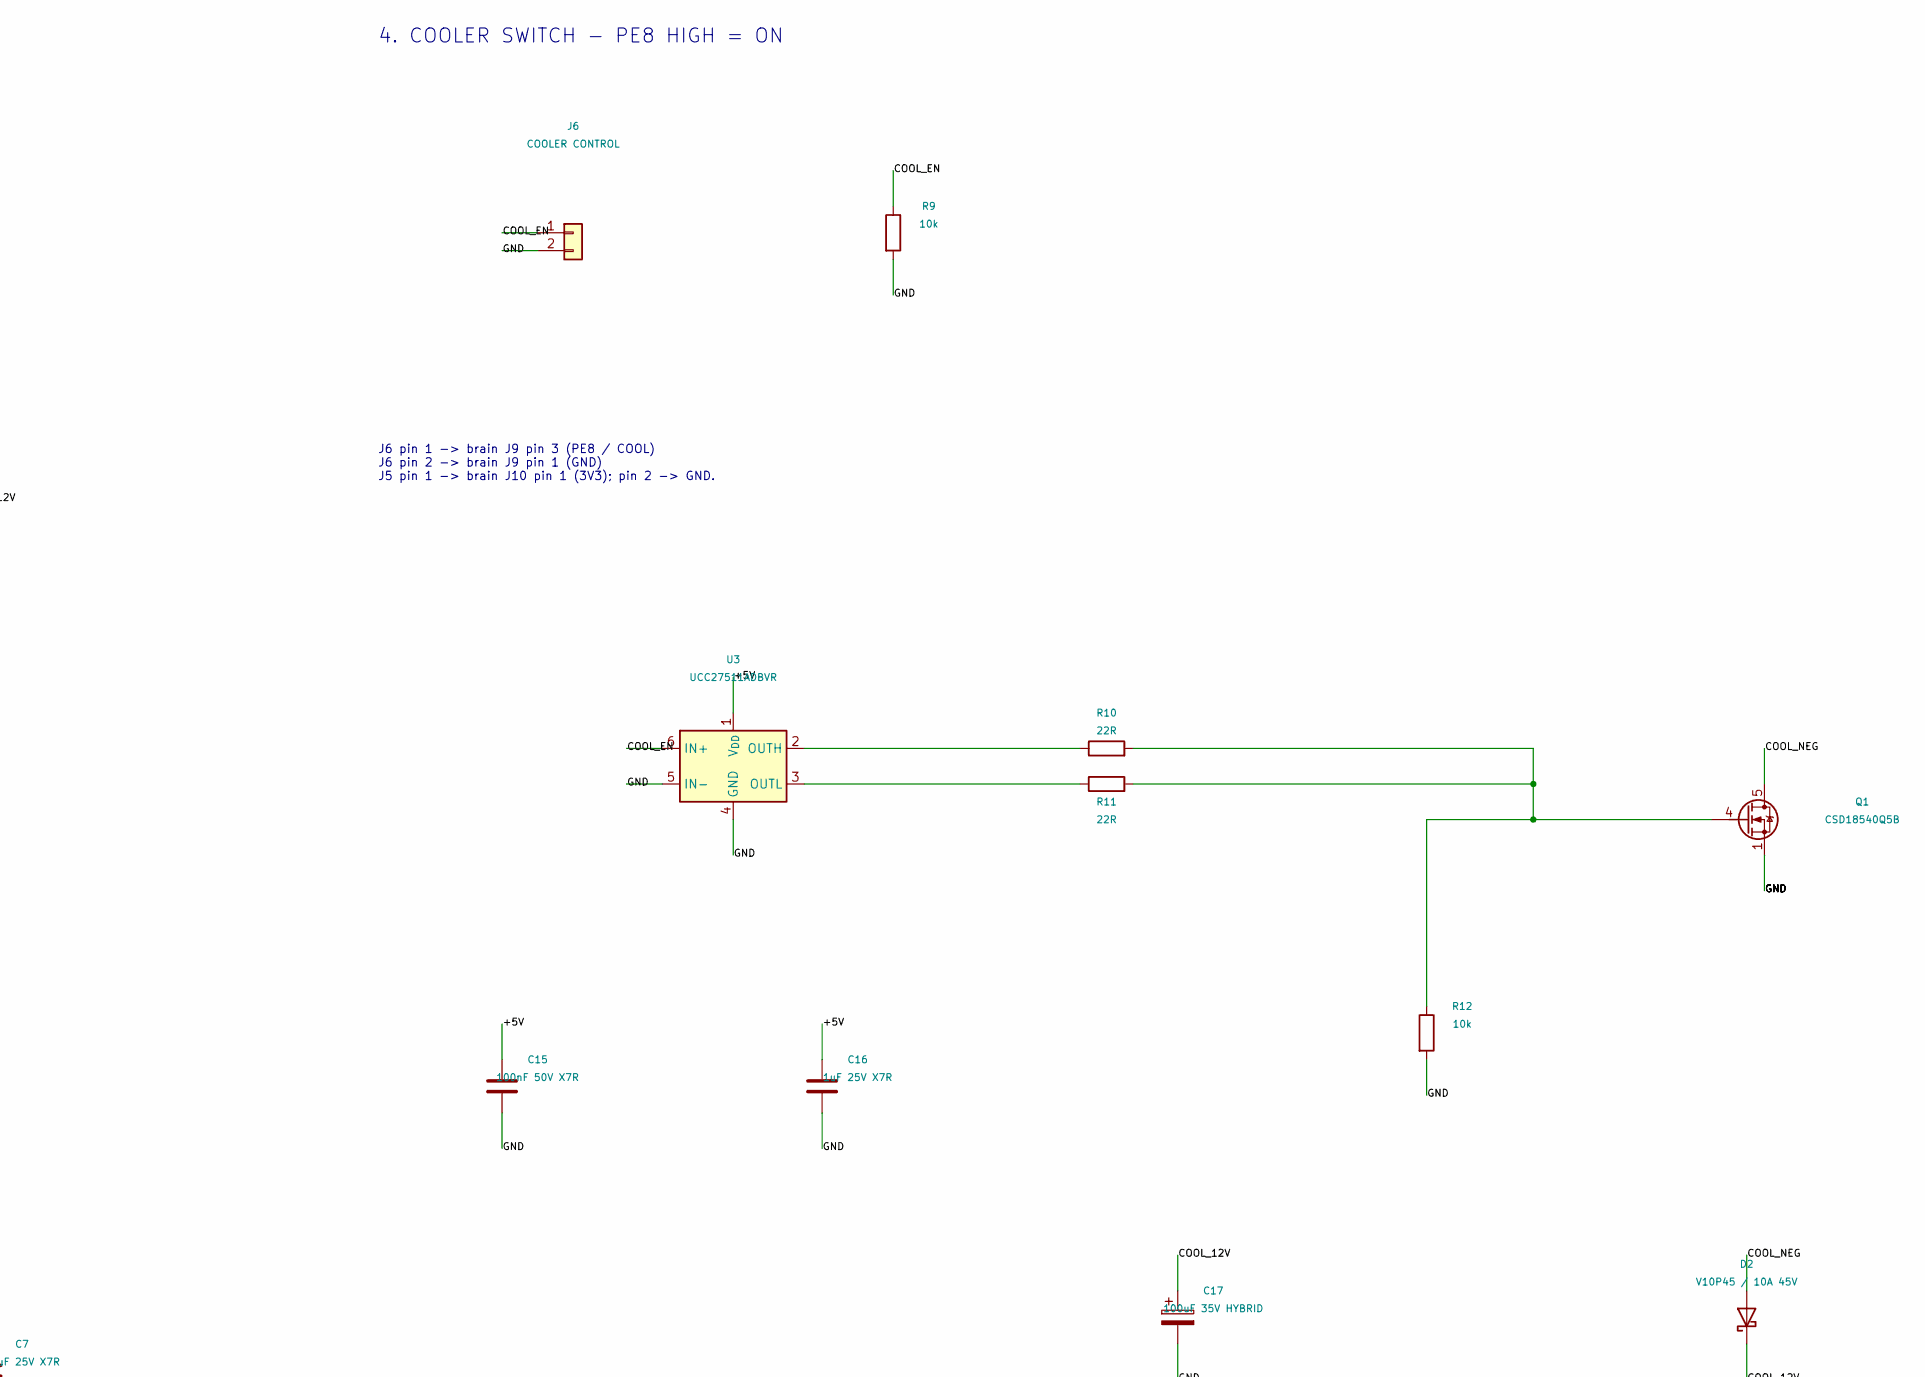
[picture p13: schematic power_PCB.kicad_sch, HYDROPONICS - POWER DISTRIBUTION AND COOLER CONTROL, part in row 1, column 2]

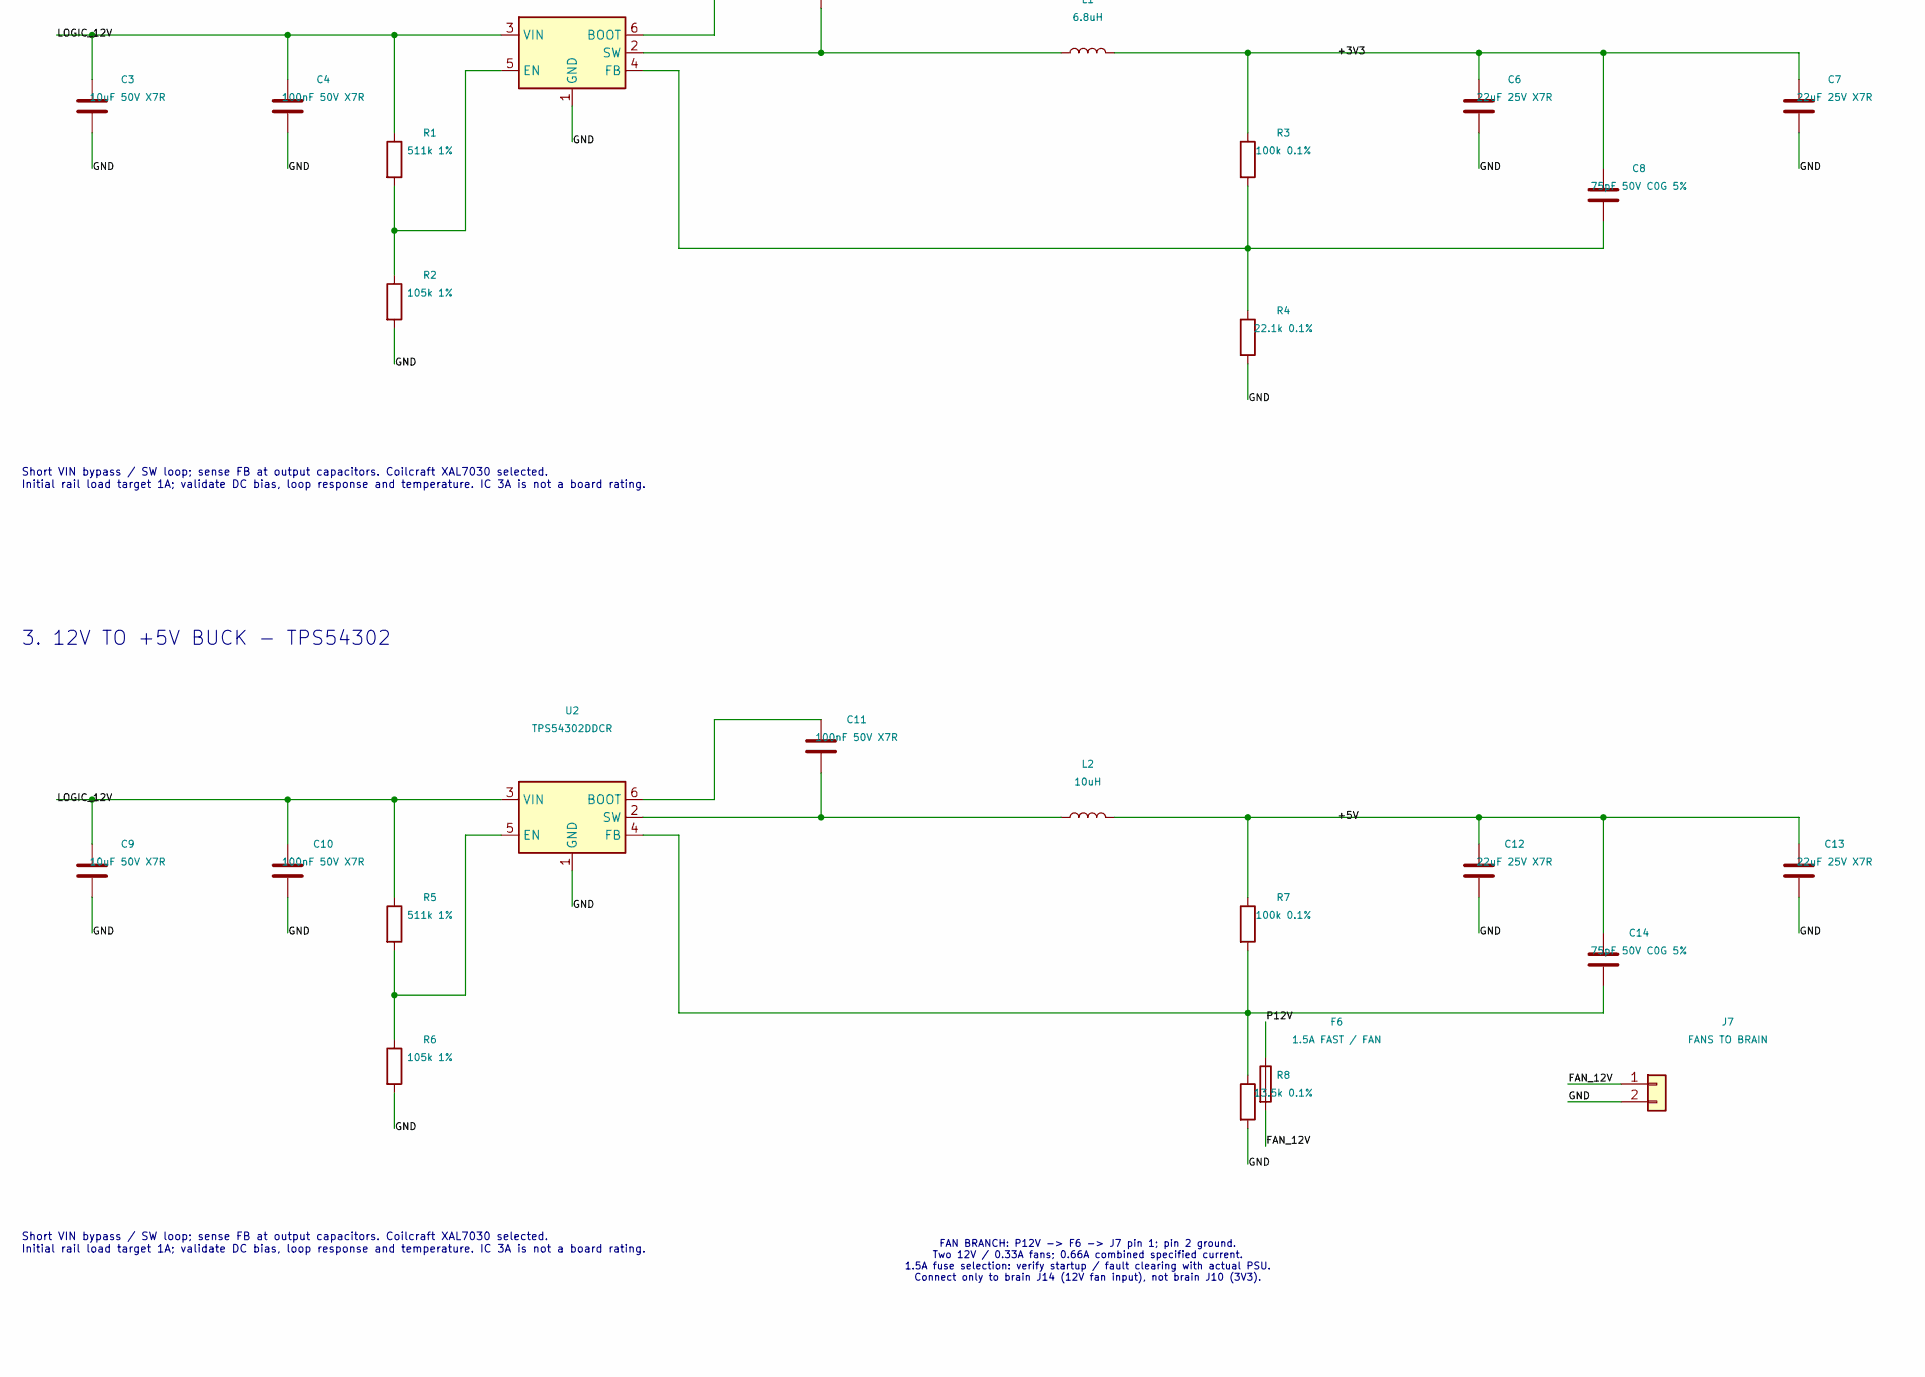
[picture p14: schematic power_PCB.kicad_sch, HYDROPONICS - POWER DISTRIBUTION AND COOLER CONTROL, part in row 2, column 1]

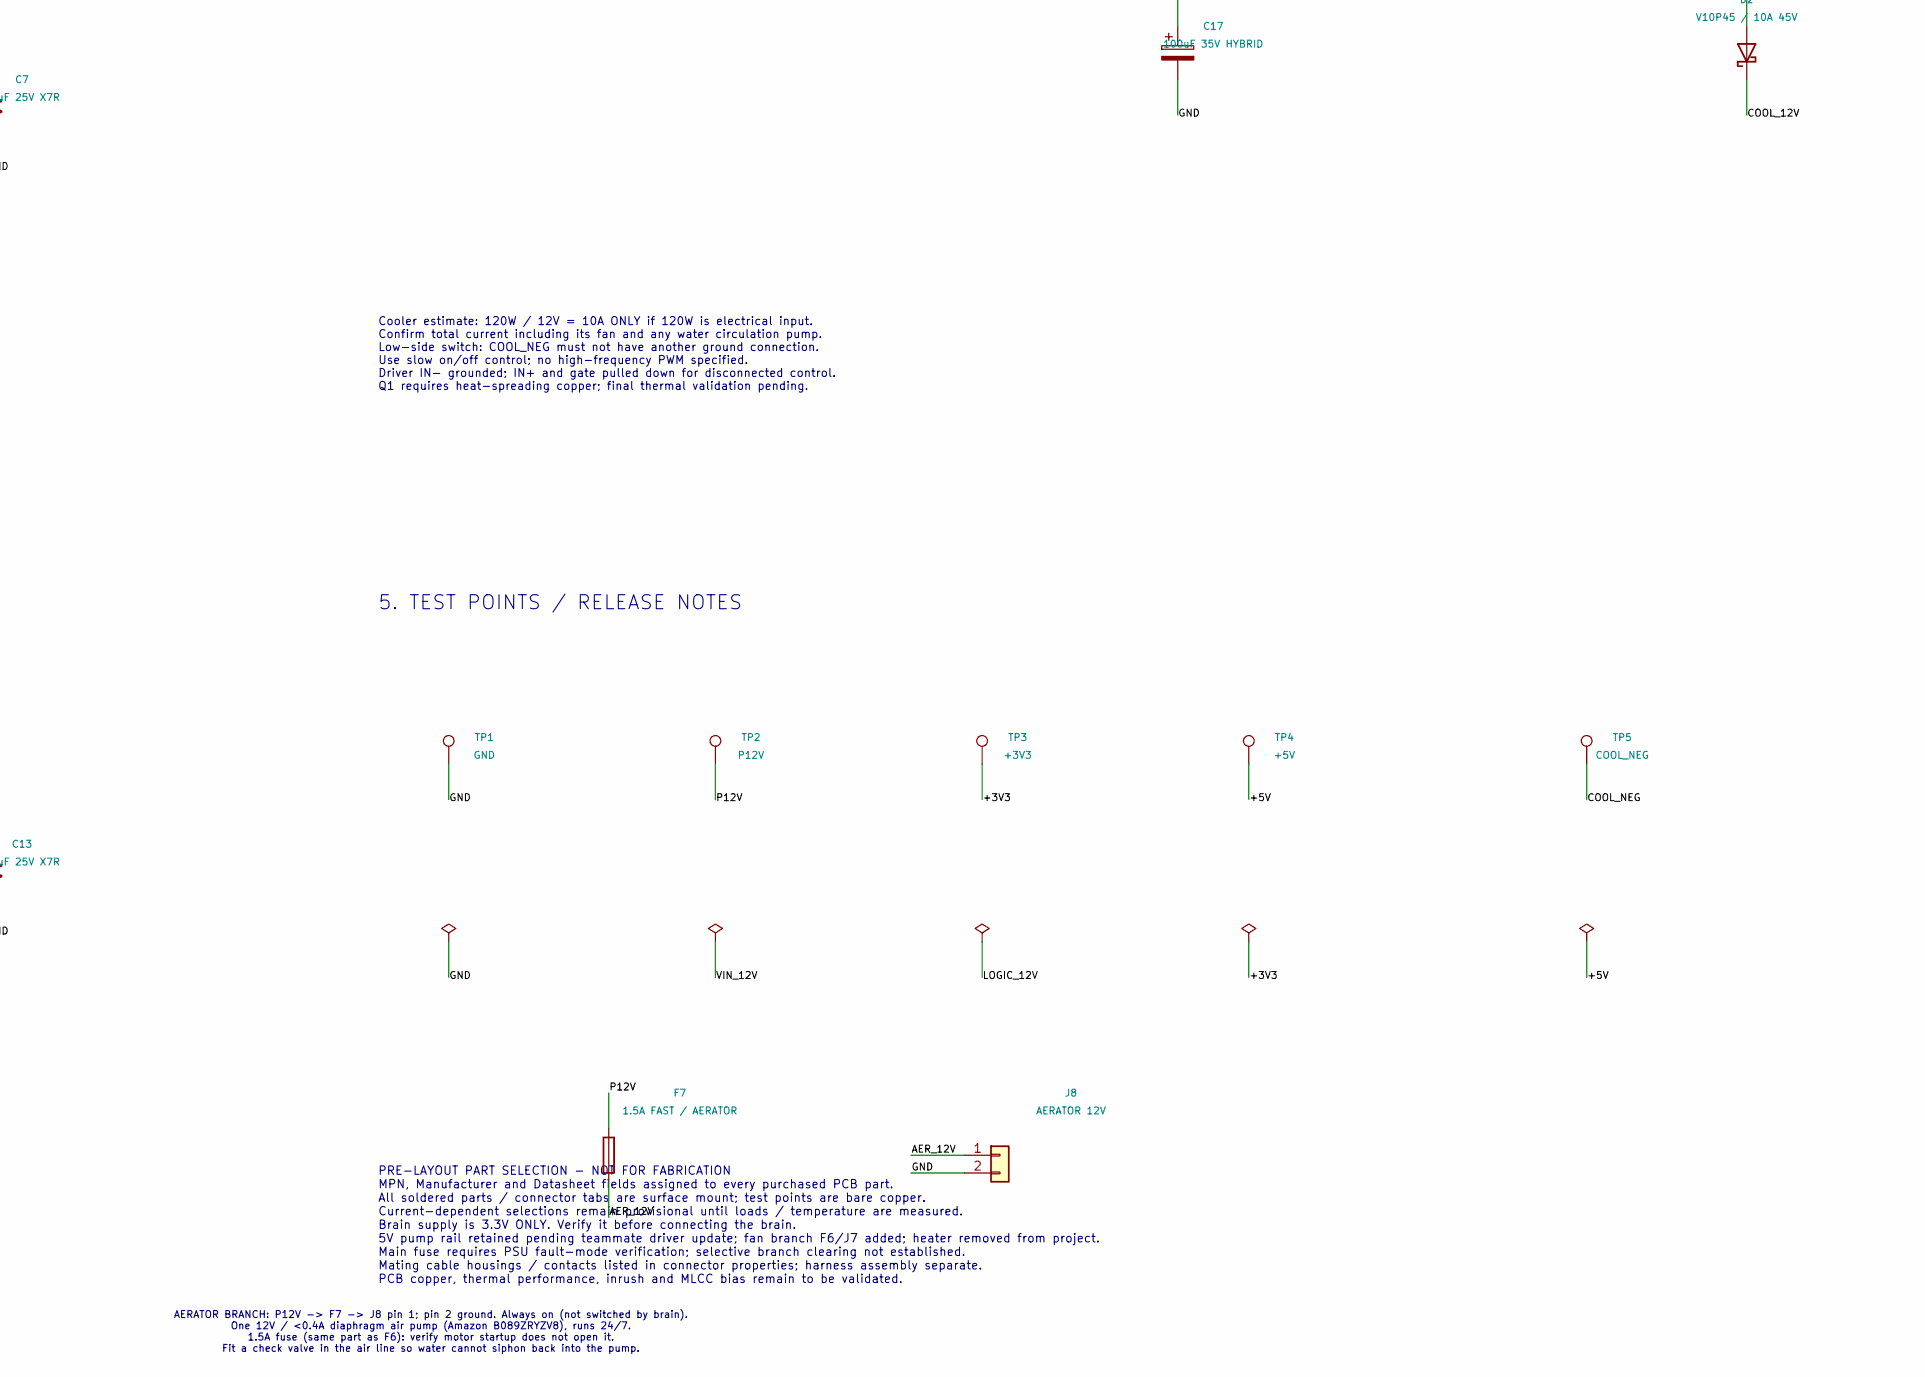
[picture p15: schematic power_PCB.kicad_sch, HYDROPONICS - POWER DISTRIBUTION AND COOLER CONTROL, part in row 2, column 2]

Parts:
C1, C17: 100uF 35V HYBRID; CP_Elec_8x10.5; MPN EEHZC1V101P; LCSC C454651
C2, C4, C5, C10, C11, C15: 100nF 50V X7R; C_0805_2012Metric; MPN GRM21BR71H104KA01L; LCSC C77082
C3, C9: 10uF 50V X7R; C_1210_3225Metric; MPN GRM32ER71H106KA12L; LCSC C77102
C6, C7, C12, C13: 22uF 25V X7R; C_1210_3225Metric; MPN GRM32ER71E226KE15L; LCSC C21397
C8, C14: 75pF 50V C0G 5%; C_0805_2012Metric; MPN CC0805JRNPO9BN750; LCSC C113832
C16: 1uF 25V X7R; C_0805_2012Metric; MPN GRM21BR71E105KA99L; LCSC C77080
D1: SMBJ15A; D_SMB; MPN SMBJ15A; LCSC C83846
D2: V10P45 / 10A 45V; Vishay_V10P45_TO-277A_K1_A2; MPN V10P45HM3_A/H; LCSC C6582752
F1: 20A FAST / PROVISIONAL; Fuse_Littelfuse-NANO2-451_453; MPN 0451020.MRL; LCSC C178980
F2: 5A FAST / PROVISIONAL; Fuse_Littelfuse-NANO2-451_453; MPN 0451005.MRL; LCSC C48467
F3, F5: 3A FAST / PROVISIONAL; Fuse_Littelfuse-NANO2-451_453; MPN 0451003.MRL; LCSC C13982
F4: 15A FAST / PROVISIONAL; Fuse_Littelfuse-NANO2-451_453; MPN 0451015.MRL; LCSC C44480
F6: 1.5A FAST / FAN; Fuse_1206_3216Metric; MPN 046601.5NR; LCSC C151136
F7: 1.5A FAST / AERATOR; Fuse_1206_3216Metric; MPN 046601.5NR; LCSC C151136
J1: 12V INPUT - 5 PAIRS; Molex_Micro-Fit_3.0_43650-1015_1x10_P3.00mm_Vertical; MPN 0436501015; LCSC C17337723
J2: LIGHT BOARD; JST_XH_B2B-XH-A_1x02_P2.50mm_Vertical; MPN B2B-XH-A(LF)(SN)
J3: PUMP BOARD; JST_XH_B3B-XH-A_1x03_P2.50mm_Vertical; MPN B3B-XH-A(LF)(SN)
J4: COOLER - 3 PAIRS; Molex_Micro-Fit_3.0_43650-0615_1x06_P3.00mm_Vertical; MPN 436500615; LCSC C505231
J5: BRAIN POWER; JST_XH_B2B-XH-A_1x02_P2.50mm_Vertical; MPN B2B-XH-A(LF)(SN)
J6: COOLER CONTROL; JST_XH_B2B-XH-A_1x02_P2.50mm_Vertical; MPN B2B-XH-A(LF)(SN)
J7: FANS TO BRAIN; JST_XH_B2B-XH-A_1x02_P2.50mm_Vertical; MPN B2B-XH-A(LF)(SN)
J8: AERATOR 12V; JST_XH_B2B-XH-A_1x02_P2.50mm_Vertical; MPN B2B-XH-A(LF)(SN)
L1: 6.8uH; L_Bourns_SRP7030CA_7.6x7.8mm; MPN SRP7030CA-6R8M; LCSC C2047432
L2: 10uH; L_Coilcraft_XAL7030-103; MPN XAL7030-103MEC; LCSC C19191652
Q1: CSD18540Q5B; TDSON-8-1; MPN CSD18540Q5B; LCSC C86513
R1, R5: 511k 1%; R_0603_1608Metric; MPN RC0603FR-07511KL; LCSC C188257
R2, R6: 105k 1%; R_0603_1608Metric; Rating 105kohm 0.1%, 0603, 100mW; MPN RT0603BRD07105KL; LCSC C861072
R3, R7: 100k 0.1%; R_0603_1608Metric; MPN RT0603BRD07100KL; LCSC C122538
R4: 22.1k 0.1%; R_0603_1608Metric; MPN RT0603BRD0722K1L; LCSC C723484
R8: 13.5k 0.1%; R_0603_1608Metric; MPN RT0603BRD0713K5L; LCSC C861118
R9, R12: 10k; R_0603_1608Metric; MPN RC0603FR-0710KL; LCSC C98220
R10, R11: 22R; R_0603_1608Metric; MPN RC0603FR-0722RL; LCSC C107701
TP1: GND; TestPoint_Pad_D2.0mm_ClearSilk
TP2: P12V; TestPoint_Pad_D2.0mm_ClearSilk
TP3: +3V3; TestPoint_Pad_D2.0mm_ClearSilk
TP4: +5V; TestPoint_Pad_D2.0mm_ClearSilk
TP5: COOL_NEG; TestPoint_Pad_D2.0mm_ClearSilk
U1, U2: TPS54302DDCR; SOT-23-6; MPN TPS54302DDCR; LCSC C311983
U3: UCC27511ADBVR; SOT-23-6; MPN UCC27511ADBVR; LCSC C2676982

Connections:
/+3V3: C6.1, C7.1, C8.1, J5.1, L1.2, R3.1, TP3.1
/+5V: C12.1, C13.1, C14.1, C15.1, C16.1, J3.2, L2.2, R7.1, TP4.1, U3.1 (V_{DD})
/AER_12V: F7.2, J8.1
/COOL_12V: C17.1, D2.1 (K), F4.2, J4.1, J4.2, J4.3
/COOL_EN: J6.1, R9.1, U3.6 (IN+)
/COOL_NEG: D2.2 (A), J4.4, J4.5, J4.6, Q1.5 (D), TP5.1
/FAN_12V: F6.2, J7.1
/GND: C1.2, C2.2, C3.2, C4.2, C6.2, C7.2, C9.2, C10.2, C12.2, C13.2, C15.2, C16.2, C17.2, D1.2 (A2), J1.6, J1.7, J1.8, J1.9, J1.10, J2.2, J3.3, J5.2, J6.2, J7.2, J8.2, Q1.1 (S), Q1.2 (S), Q1.3 (S), R2.2, R4.2, R6.2, R8.2, R9.2, R12.2, TP1.1, U1.1 (GND), U2.1 (GND), U3.4 (GND), U3.5 (IN-)
/LIGHT_12V: F2.2, J2.1
/LOGIC_12V: C3.1, C4.1, C9.1, C10.1, F5.2, R1.1, R5.1, U1.3 (VIN), U2.3 (VIN)
/P12V: C1.1, C2.1, D1.1 (A1), F1.2, F2.1, F3.1, F4.1, F5.1, F6.1, F7.1, TP2.1
/PUMP_12V: F3.2, J3.1
/VIN_12V: F1.1, J1.1, J1.2, J1.3, J1.4, J1.5
unnamed: Q1.4 (G), R10.2, R11.2, R12.1
unnamed: C5.1, U1.6 (BOOT)
unnamed: R1.2, R2.1, U1.5 (EN)
unnamed: C8.2, R3.2, R4.1, U1.4 (FB)
unnamed: C5.2, L1.1, U1.2 (SW)
unnamed: C11.1, U2.6 (BOOT)
unnamed: R5.2, R6.1, U2.5 (EN)
unnamed: C14.2, R7.2, R8.1, U2.4 (FB)
unnamed: C11.2, L2.1, U2.2 (SW)
unnamed: R10.1, U3.2 (OUTH)
unnamed: R11.1, U3.3 (OUTL)

Notes on the sheet:
AERATOR BRANCH: P12V -> F7 -> J8 pin 1; pin 2 ground. Always on (not switched by brain). One 12V / <0.4A diaphragm air pump (Amazon B089ZRYZV8), runs 24/7. 1.5A fuse (same part as F6): verify motor startup does not open it. Fit a check valve in the air line so water cannot siphon back into the pump.
1. 12V INPUT / FUSED DISTRIBUTION
J1: pins 1-5 = +12V input; pins 6-10 = GND. Use all five 18AWG wires per polarity. J4: pins 1-3 = fused +12V; pins 4-6 = COOL_NEG. Use all three 18AWG wires per polarity. Equal wire lengths and sound crimps required; validate contact current sharing / temperature. Provisional total continuous budge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
2. 12V TO +3V3 BUCK - TPS54302
Short VIN bypass / SW loop; sense FB at output capacitors. Coilcraft XAL7030 selected. Initial rail load target 1A; validate DC bias, loop response and temperature. IC 3A is not a board rating.
3. 12V TO +5V BUCK - TPS54302
4. COOLER SWITCH - PE8 HIGH = ON
J6 pin 1 -> brain J9 pin 3 (PE8 / COOL) J6 pin 2 -> brain J9 pin 1 (GND) J5 pin 1 -> brain J10 pin 1 (3V3); pin 2 -> GND.
Cooler estimate: 120W / 12V = 10A ONLY if 120W is electrical input. Confirm total current including its fan and any water circulation pump. Low-side switch: COOL_NEG must not have another ground connection. Use slow on/off control; no high-frequency PWM specified. Driver IN- grounded; IN+ and gate 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
5. TEST POINTS / RELEASE NOTES
PRE-LAYOUT PART SELECTION - NOT FOR FABRICATION MPN, Manufacturer and Datasheet fields assigned to every purchased PCB part. All soldered parts / connector tabs are surface mount; test points are bare copper. Current-dependent selections remain provisional until loads / temperature are measured. Br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
FAN BRANCH: P12V -> F6 -> J7 pin 1; pin 2 ground. Two 12V / 0.33A fans; 0.66A combined specified current. 1.5A fuse selection: verify startup / fault clearing with actual PSU. Connect only to brain J14 (12V fan input), not brain J10 (3V3).

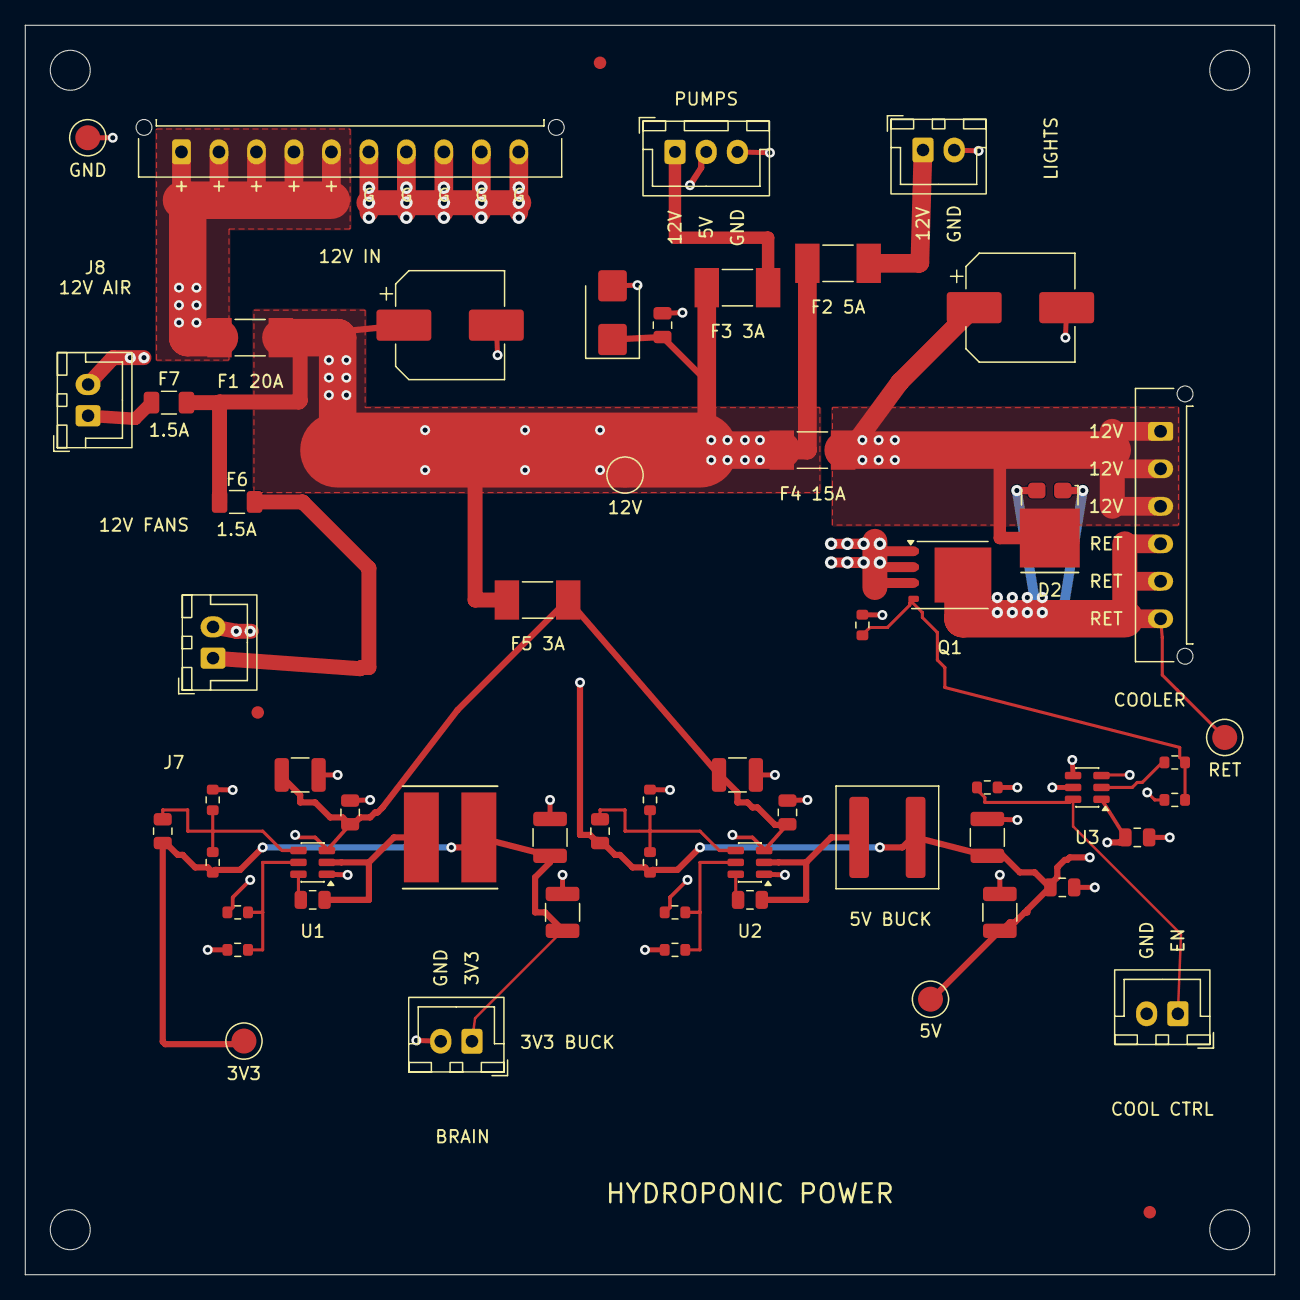
[picture p16: board power_PCB.kicad_pcb from above]

Board: 4 copper layers, 100.0 x 100.0 mm, 64 parts (0 on the bottom side), 24 nets.

Other parts of the board:
FID1, FID2, FID3: Fiducial_1mm_Mask2mm
H1, H2, H3, H4: MountingHole_3.2mm_M3
