oudehm/seniorDesignPCB/pump_PCB/pump_PCB.kicad_pcb

## KiCad design pump_PCB/pump_PCB.kicad_pcb (2026-09-28)

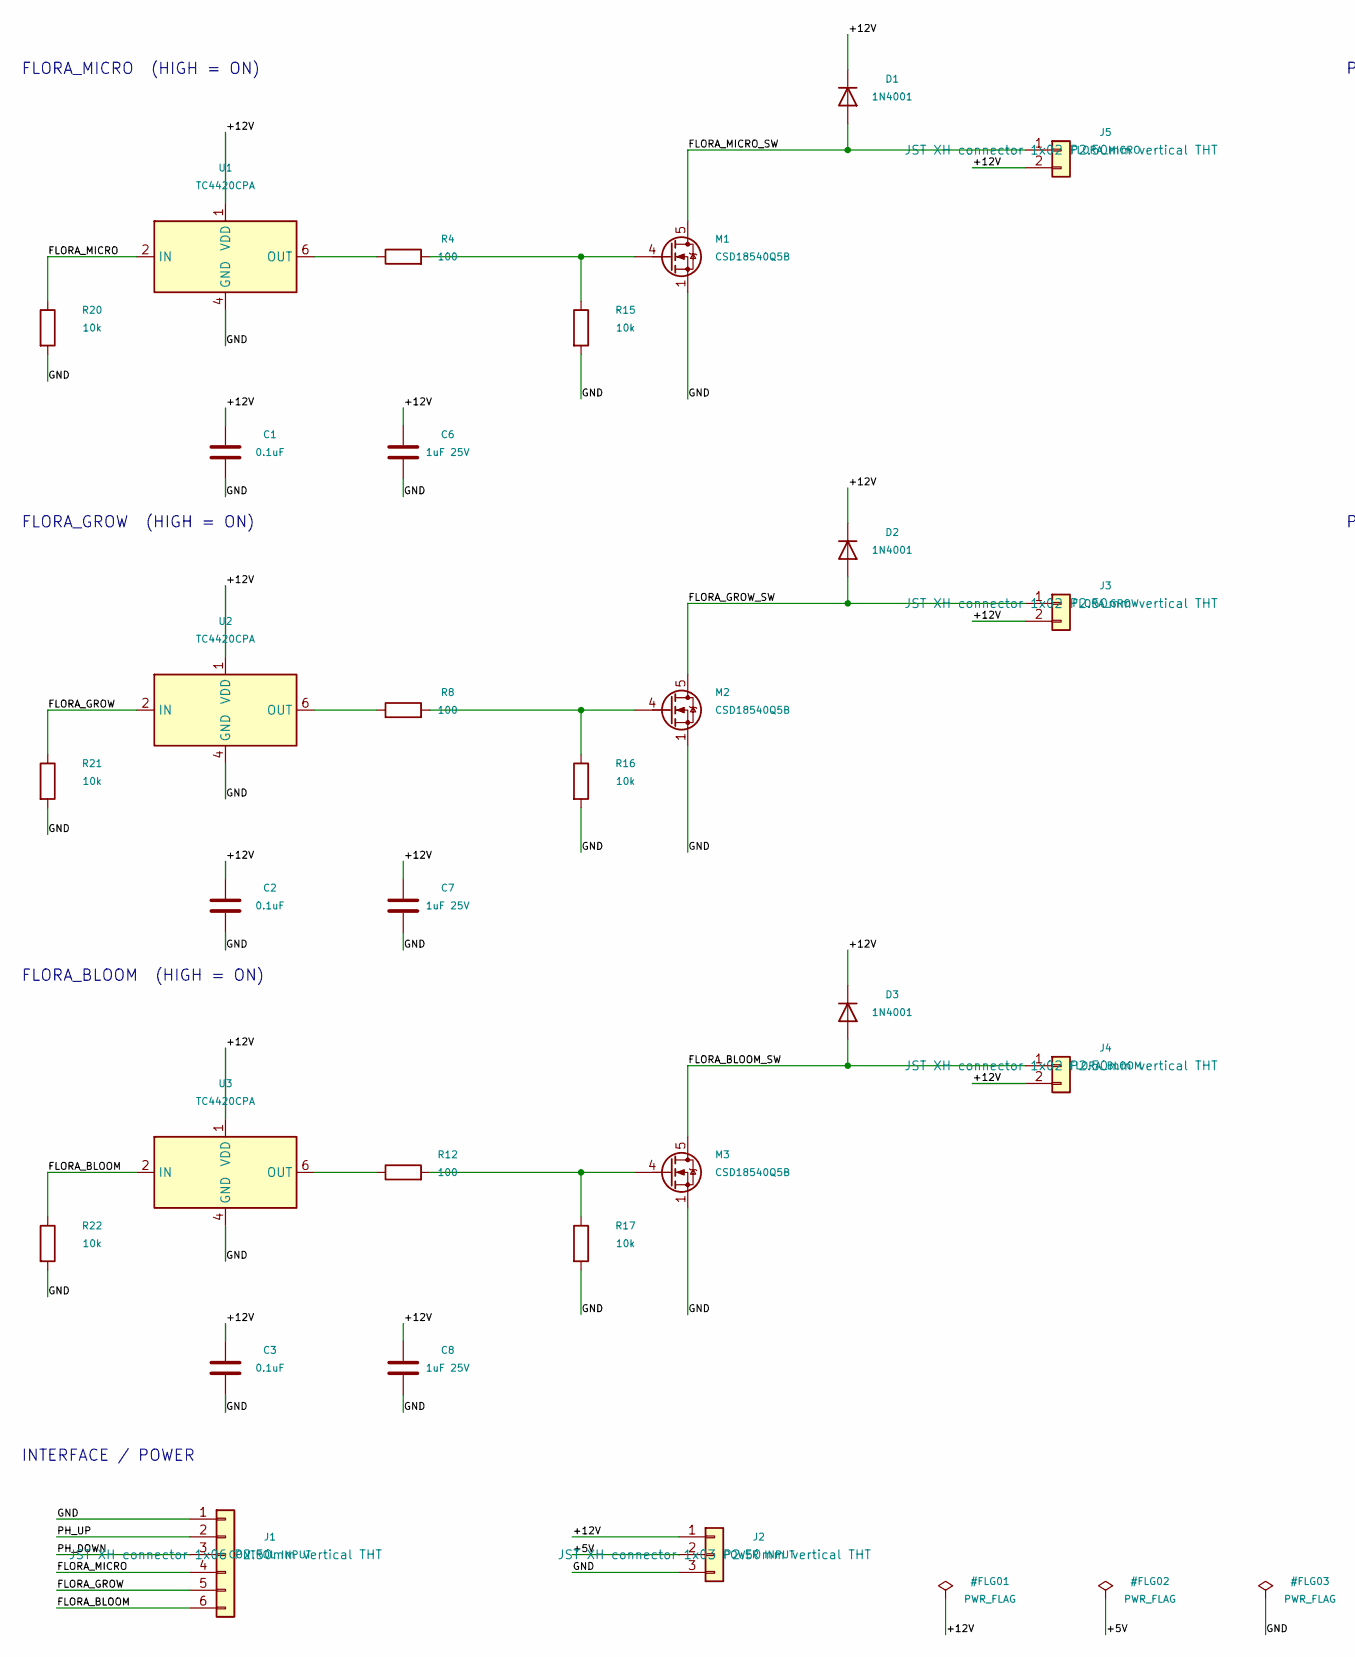
[picture p17: schematic pump_PCB.kicad_sch, Hydroponics - five-channel pump driver, part in row 1, column 1]

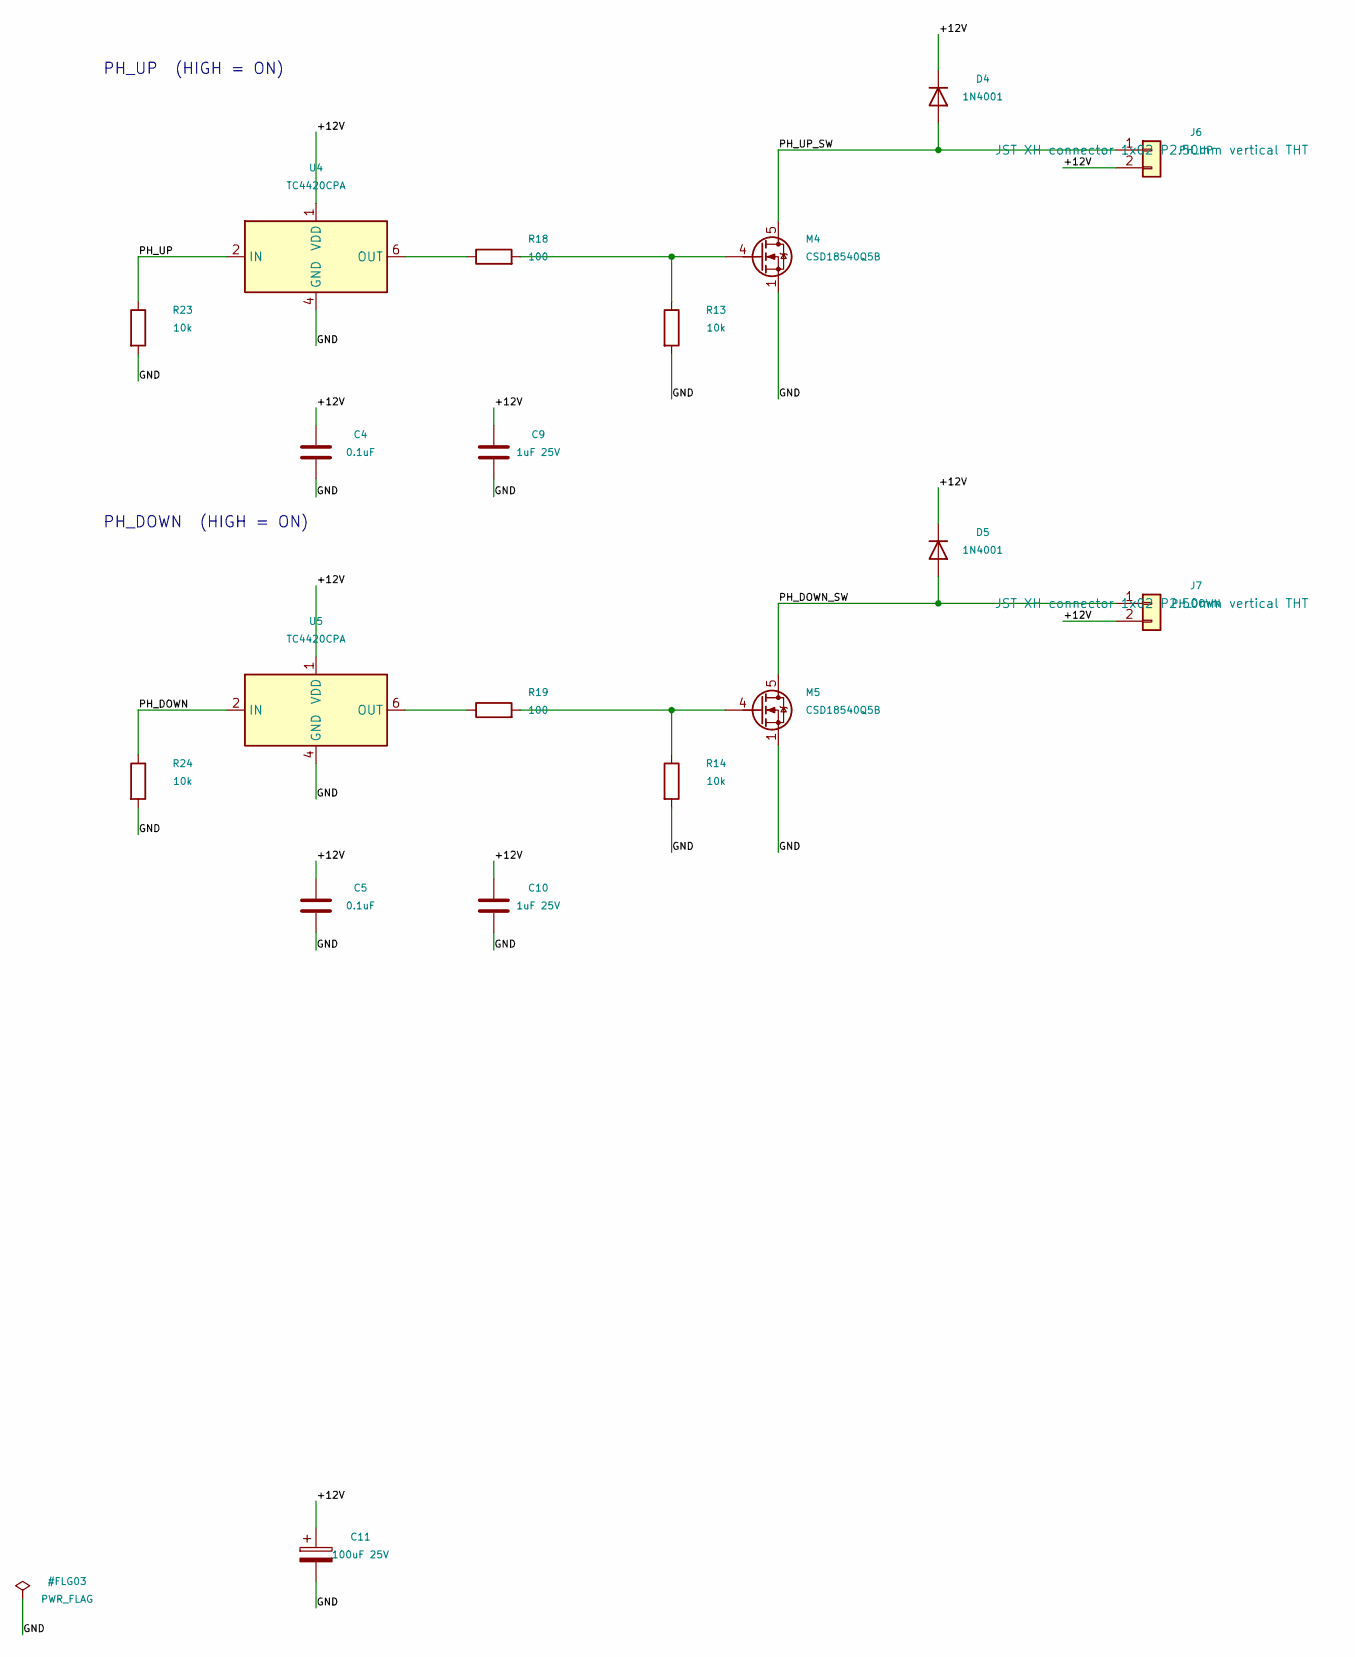
[picture p18: schematic pump_PCB.kicad_sch, Hydroponics - five-channel pump driver, part in row 1, column 2]

Parts:
C1, C2, C3, C4, C5: 0.1uF; C_0603_1608Metric; Rating 100nF 50V X7R; MPN GRM188R71H104KA93D; LCSC C77055
C6, C7, C8, C9, C10: 1uF 25V; C_0603_1608Metric; Rating 1uF 25V X7R; MPN GRM188R71E105KA12D; LCSC C86020
C11: 100uF 25V; CP_Radial_D6.3mm_P2.50mm; Rating 100uF 25V, 6.3mm diameter x 11.2mm heig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; MPN EEUFM1E101; LCSC C713389
D1, D2, D3, D4, D5: 1N4001; D_DO-41_SOD81_P10.16mm_Horizontal; Rating 1A, 50V, DO-41; MPN 1N4001-E3/54; LCSC C145305
J1: CONTROL INPUT; JST_XH_B6B-XH-A_1x06_P2.50mm_Vertical; MPN B6B-XH-A(LF)(SN)
J2: POWER INPUT; JST_XH_B3B-XH-A_1x03_P2.50mm_Vertical; MPN B3B-XH-A(LF)(SN)
J3: FLORA_GROW; JST_XH_B2B-XH-A_1x02_P2.50mm_Vertical; MPN B2B-XH-A(LF)(SN)
J4: FLORA_BLOOM; JST_XH_B2B-XH-A_1x02_P2.50mm_Vertical; MPN B2B-XH-A(LF)(SN)
J5: FLORA_MICRO; JST_XH_B2B-XH-A_1x02_P2.50mm_Vertical; MPN B2B-XH-A(LF)(SN)
J6: PH_UP; JST_XH_B2B-XH-A_1x02_P2.50mm_Vertical; MPN B2B-XH-A(LF)(SN)
J7: PH_DOWN; JST_XH_B2B-XH-A_1x02_P2.50mm_Vertical; MPN B2B-XH-A(LF)(SN)
M1, M2, M3, M4, M5: CSD18540Q5B; CSD18540Q5B_TI; MPN CSD18540Q5B; LCSC C86513
R4, R8, R12, R18, R19: 100; R_Axial_DIN0207_L6.3mm_D2.5mm_P10.16mm_Horizontal; Rating 1%, 0.25W axial; formed 10.16mm lead pi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; MPN MFR-25FBF52-100R; LCSC C6300650
R13, R14, R15, R16, R17, R20, R21, R22, R23, R24: 10k; R_Axial_DIN0207_L6.3mm_D2.5mm_P10.16mm_Horizontal; Rating 1%, 0.25W axial; formed 10.16mm lead pi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; MPN MFR-25FBF52-10K; LCSC C1519255
U1, U2, U3, U4, U5: TC4420CPA; DIP-8_W7.62mm; Rating Non-inverting driver, PDIP8; 12V gate r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; MPN TC4420CPA; LCSC C48733

Connections:
/+5V: J2.2
/+12V: C1.1, C2.1, C3.1, C4.1, C5.1, C6.1, C7.1, C8.1, C9.1, C10.1, C11.1, D1.1 (K), D2.1 (K), D3.1 (K), D4.1 (K), D5.1 (K), J2.1, J3.2, J4.2, J5.2, J6.2, J7.2, U1.1 (VDD), U1.8 (VDD), U2.1 (VDD), U2.8 (VDD), U3.1 (VDD), U3.8 (VDD), U4.1 (VDD), U4.8 (VDD), U5.1 (VDD), U5.8 (VDD)
/FLORA_BLOOM: J1.6, R22.1, U3.2 (IN)
/FLORA_BLOOM_SW: D3.2 (A), J4.1, M3.5 (D)
/FLORA_GROW: J1.5, R21.1, U2.2 (IN)
/FLORA_GROW_SW: D2.2 (A), J3.1, M2.5 (D)
/FLORA_MICRO: J1.4, R20.1, U1.2 (IN)
/FLORA_MICRO_SW: D1.2 (A), J5.1, M1.5 (D)
/GND: C1.2, C2.2, C3.2, C4.2, C5.2, C6.2, C7.2, C8.2, C9.2, C10.2, C11.2, J1.1, J2.3, M1.1 (S), M1.2 (S), M1.3 (S), M2.1 (S), M2.2 (S), M2.3 (S), M3.1 (S), M3.2 (S), M3.3 (S), M4.1 (S), M4.2 (S), M4.3 (S), M5.1 (S), M5.2 (S), M5.3 (S), R13.2, R14.2, R15.2, R16.2, R17.2, R20.2, R21.2, R22.2, R23.2, R24.2, U1.4 (GND), U1.5 (GND), U2.4 (GND), U2.5 (GND), U3.4 (GND), U3.5 (GND), U4.4 (GND), U4.5 (GND), U5.4 (GND), U5.5 (GND)
/PH_DOWN: J1.3, R24.1, U5.2 (IN)
/PH_DOWN_SW: D5.2 (A), J7.1, M5.5 (D)
/PH_UP: J1.2, R23.1, U4.2 (IN)
/PH_UP_SW: D4.2 (A), J6.1, M4.5 (D)
unnamed: M1.4 (G), R4.2, R15.1
unnamed: M2.4 (G), R8.2, R16.1
unnamed: M3.4 (G), R12.2, R17.1
unnamed: M4.4 (G), R13.1, R18.2
unnamed: M5.4 (G), R14.1, R19.2
unnamed: R4.1, U1.6 (OUT), U1.7 (OUT)
unnamed: R8.1, U2.6 (OUT), U2.7 (OUT)
unnamed: R12.1, U3.6 (OUT), U3.7 (OUT)
unnamed: R18.1, U4.6 (OUT), U4.7 (OUT)
unnamed: R19.1, U5.6 (OUT), U5.7 (OUT)

Notes on the sheet:
FLORA_BLOOM (HIGH = ON)
PH_UP (HIGH = ON)
FLORA_MICRO (HIGH = ON)
PH_DOWN (HIGH = ON)
INTERFACE / POWER
FLORA_GROW (HIGH = ON)
