oudehm/seniorDesignPCB/pump_PCB/pump_PCB.kicad_pcb

## KiCad design pump_PCB/pump_PCB.kicad_pcb (continued)

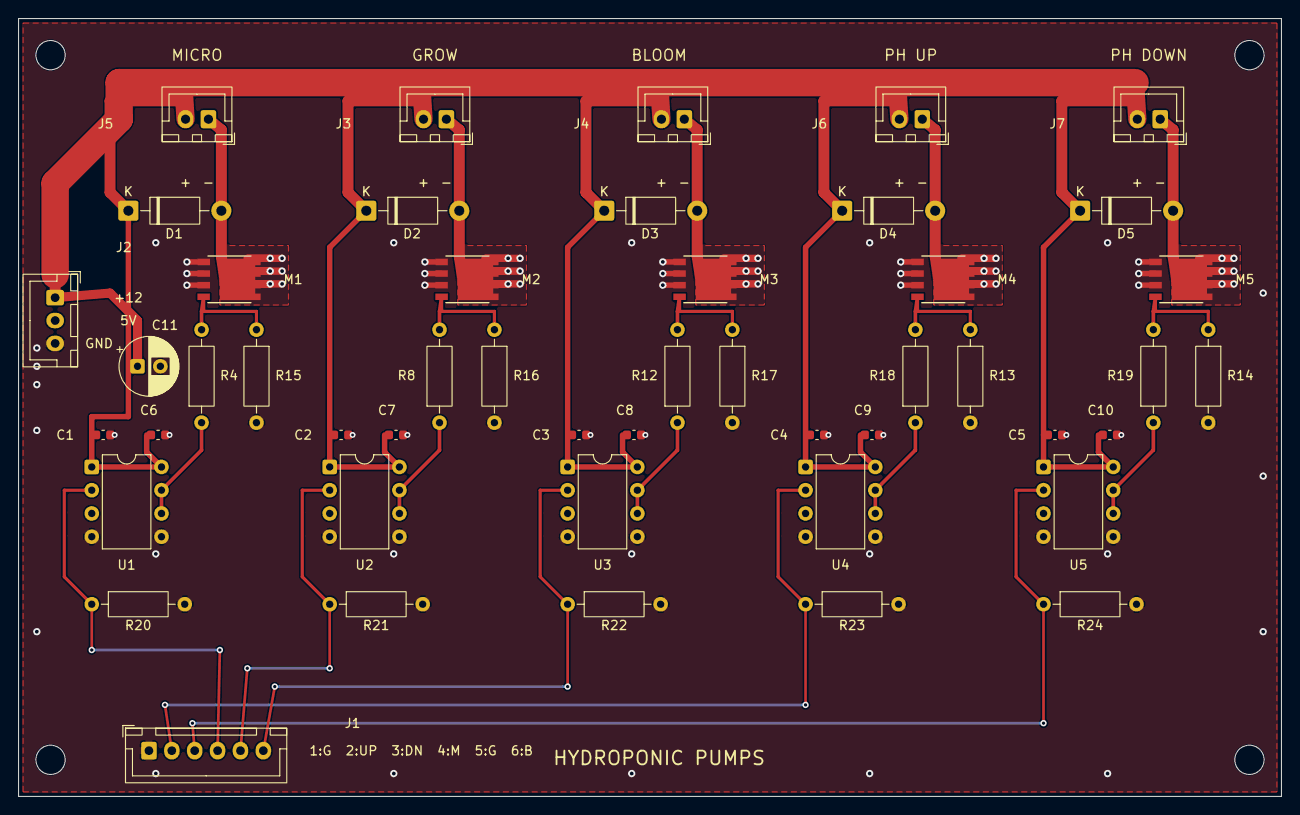
[picture p19: board pump_PCB.kicad_pcb from above]

Board: 2 copper layers, 138.0 x 85.0 mm, 52 parts (0 on the bottom side), 22 nets.

Other parts of the board:
H1, H2, H3, H4: MountingHole_3.2mm_M3
