oudehm/seniorDesignPCB/(commit log)

2026-06-03 initial project structure
    [brain_PCB.kicad_pcb, brain_PCB.kicad_sch, light_PCB.kicad_pcb, light_PCB.kicad_sch, power_PCB.kicad_pcb, power_PCB.kicad_sch, pump_PCB.kicad_pcb, pump_PCB.kicad_sch]
2026-06-03 brain PCB schematic in progress: power pins, decoupling caps, VCAP, crystals, reset, boot, SWD, UART, analog sensors, temp probes
    [brain_PCB.kicad_sch]
2026-06-08 full schematic complete; minor warnings regarding labels
    [brain_PCB.kicad_sch]
2026-06-08 brain PCB schematic: footprints assigned, ready for PCB layout
    [brain_PCB.kicad_sch]
2026-06-08 initial PCB placementt
    [brain_PCB.kicad_pcb, brain_PCB.kicad_sch]
2026-08-10 brain PCB routing complete: GND pours on outer layers, stitching vias, SI fixes; electrical DRC clean
    [brain_PCB.kicad_pcb, brain_PCB.kicad_sch]
2026-08-10 brain PCB: resize board to 69.7x63.6mm, add M3 mounting holes, silkscreen label cleanup
    [brain_PCB.kicad_pcb]
2026-09-07 brain PCB: add connector silkscreen labels, fix decoupling cap thermal relief for SMT assembly
    [brain_PCB.kicad_pcb]
2026-09-11 all boards routed: light rev B (SOT-23 switches, protected input), pump rev B (CSD18540 MOSFETs), power rev A1 (parts selected), brain Micro-Fit connectors + display on edge; whitelist gitignore
    Light, power and pump pass DRC and ERC clean. Brain routed with 0 unconnected; remaining warnings are dangling vias, thin silk text and missing no-connect flags. All cable connectors standardized to Molex Micro-Fit 3.0. Repo now tracks only the KiCad project files, design rules, local libraries and brain 3D models.
    [brain_PCB.kicad_pcb, brain_PCB.kicad_sch, light_PCB.kicad_pcb, light_PCB.kicad_sch, power_PCB.kicad_pcb, power_PCB.kicad_sch, pump_PCB.kicad_pcb, pump_PCB.kicad_sch]
2026-09-28 Update four KiCad designs and include portable project libraries
    [brain_PCB.kicad_pcb, brain_PCB.kicad_sch, light_PCB.kicad_pcb, light_PCB.kicad_sch, power_PCB.kicad_pcb, power_PCB.kicad_sch, pump_PCB.kicad_pcb, pump_PCB.kicad_sch]
2026-09-28 Add 3D board previews to README
2026-09-28 Describe each board in README
